Wesleyan-Soft-Robots-Lab/ArduinoMotors/Documentation/pneumaticuse.md

This is a tutorial on how to use the pneumatic board when testing using arm straps

THE ARDUINO BOARD
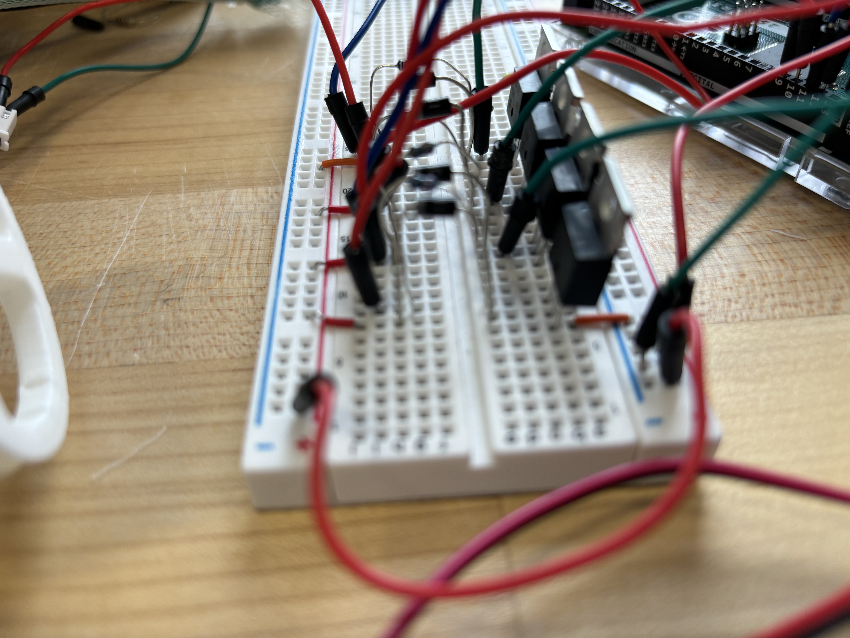
[picture p5: Documentation/images/circuit.jpeg]
1. 
To ensure that the solenoid works functionally, first we want to plug in the red and green wires connected to the solenoid into the board. 
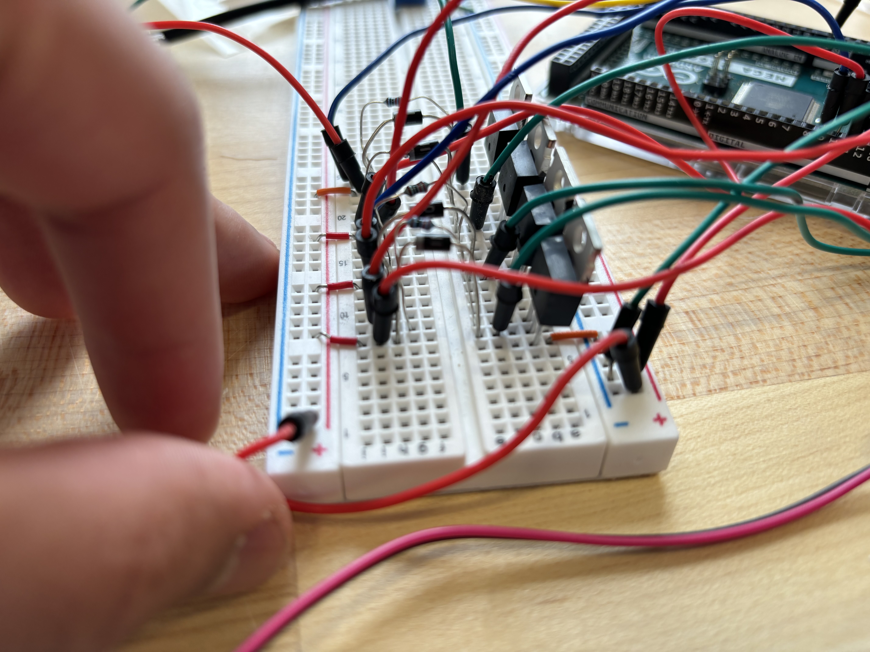
[picture p6: Documentation/images/circuitwire.jpeg]

The green wire should be plugged in to the right side of the board, in between the snubber diode and the transistor. The red wire should be plugged in to the left side of the board, right next to the left side of the snubber diode. 

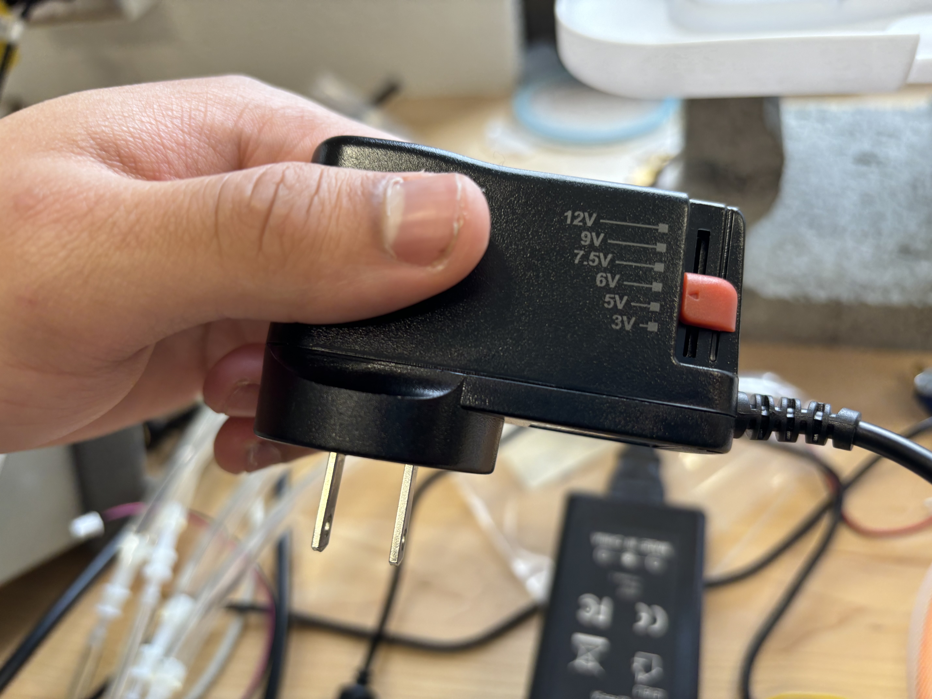
[picture p7: Documentation/images/powersupply.jpeg]
step 2
2. 
Ensure that the power supply is set to release 7.5V. 

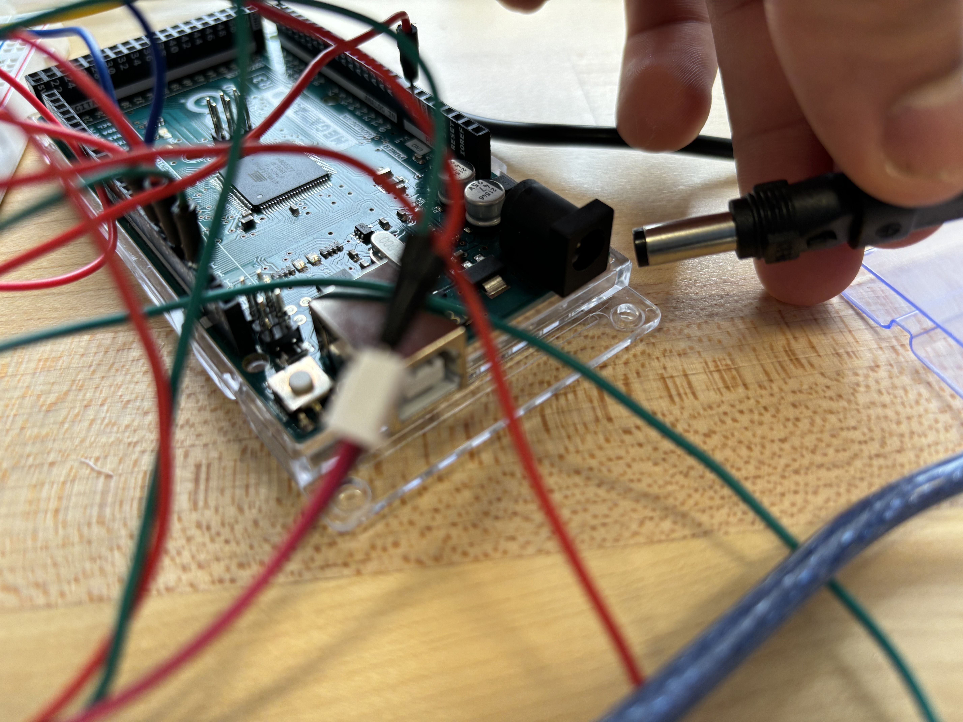
[picture p8: Documentation/images/power.jpeg]
step 3
3. 
Plug the power into the Arduino Mega.

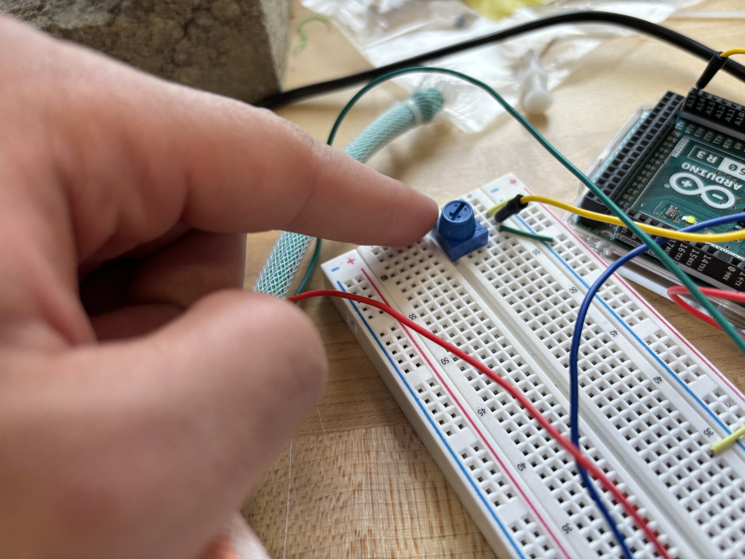
[picture p9: Documentation/images/valve.jpeg]
step 4
4. 

Once the Arduino is plugged in, turn the blue dial to increase or decrease the rate at which the air is being released to the balloon straps. This dial controls the rate at which the solenoid will open and close for airflow.

THE AIRPUMP

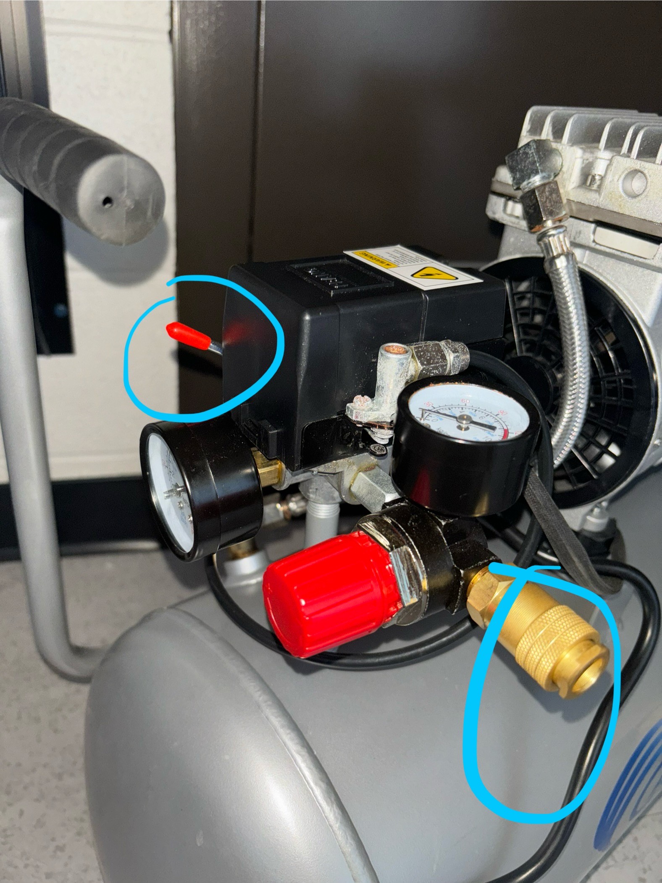
[picture p10: Documentation/images/pumpon.jpeg]
step 5
5. 

First, we want to ensure that the airpump is plugged into a power source. Once that is complete, there are two important parts to be aware of. The top circled part is to turn on the airpump. The bottom knozzle is to release the air into our board. To fill the pump with air, flip the top red switch on and let it fill. (I usually fill the pump up to 30kpa, for our current 4 tube model. However you may need more or less depending on your needs)

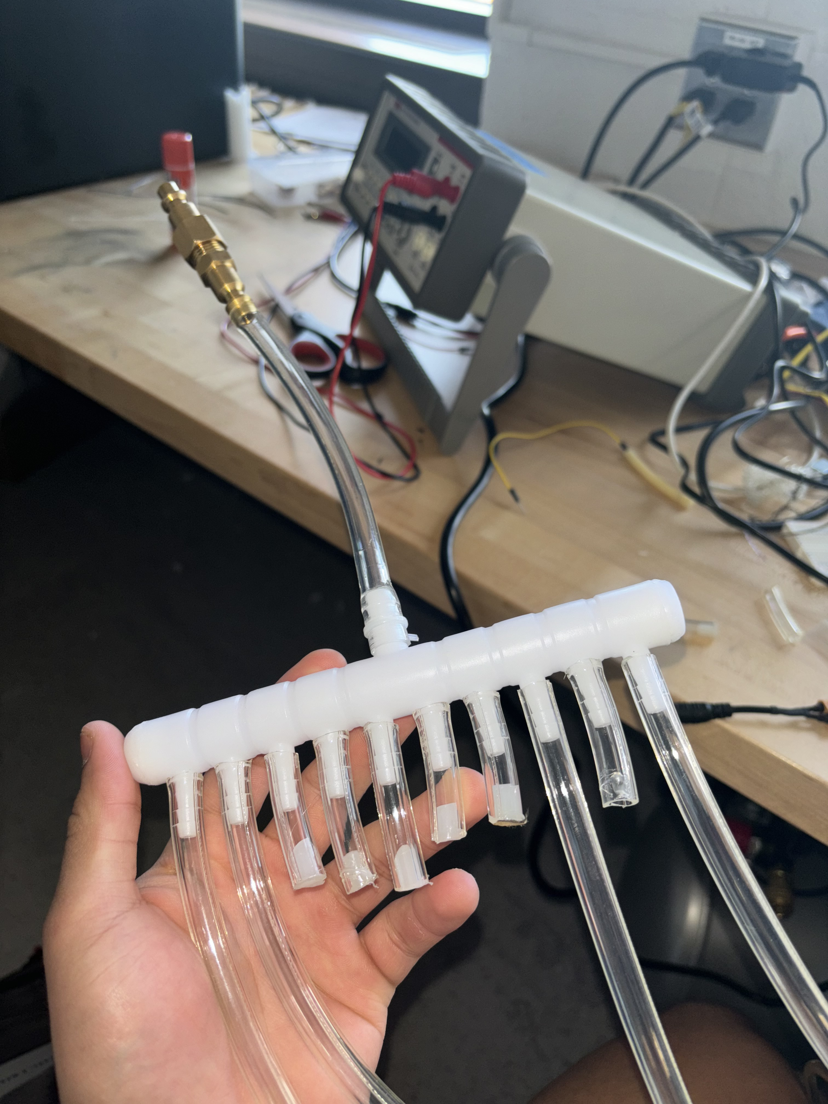
[picture p11: Documentation/images/tubeplug.jpeg]
6. 

Take the air tube divider. Ensure that every output which will not be used is plugged so that no air is lost. Then ensure that the ones that will be used are plugged in correctly.

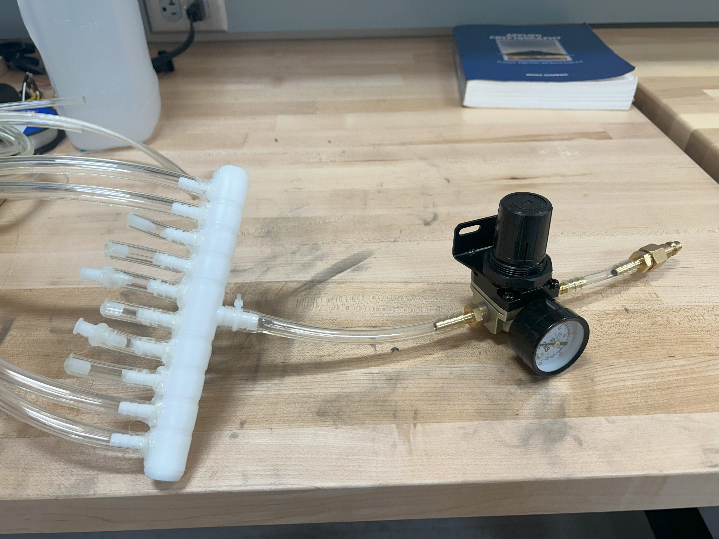
[picture p12: Documentation/images/regulator.jpeg]
6a.  

At the input of the airtube divider a pressure regulator has been installed to allow for finer adjustments to the pressure release. To increases airflow, rotate the valve clockwise. Rotating the valve counter-clockwise decreases airflow.
<br>***note: the valve has a push lock. The adjustment is locked when pushed in, and unlocked when out***

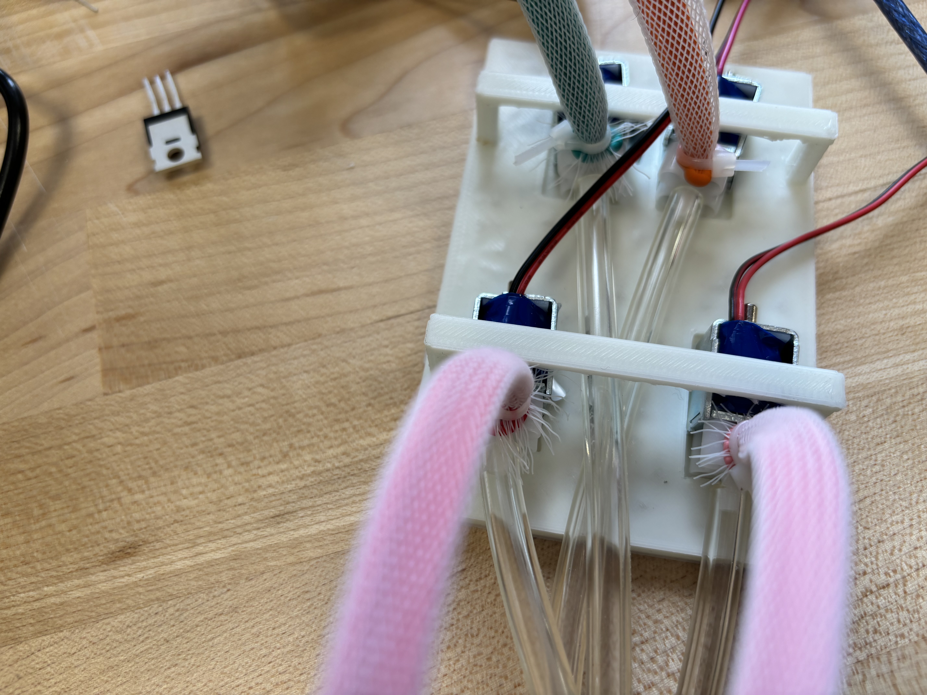
[picture p13: Documentation/images/tubing.jpeg]
step 7
7. 

Now ensure that the tubes are correctly connected to the pneumatic board as shown in the image above. 

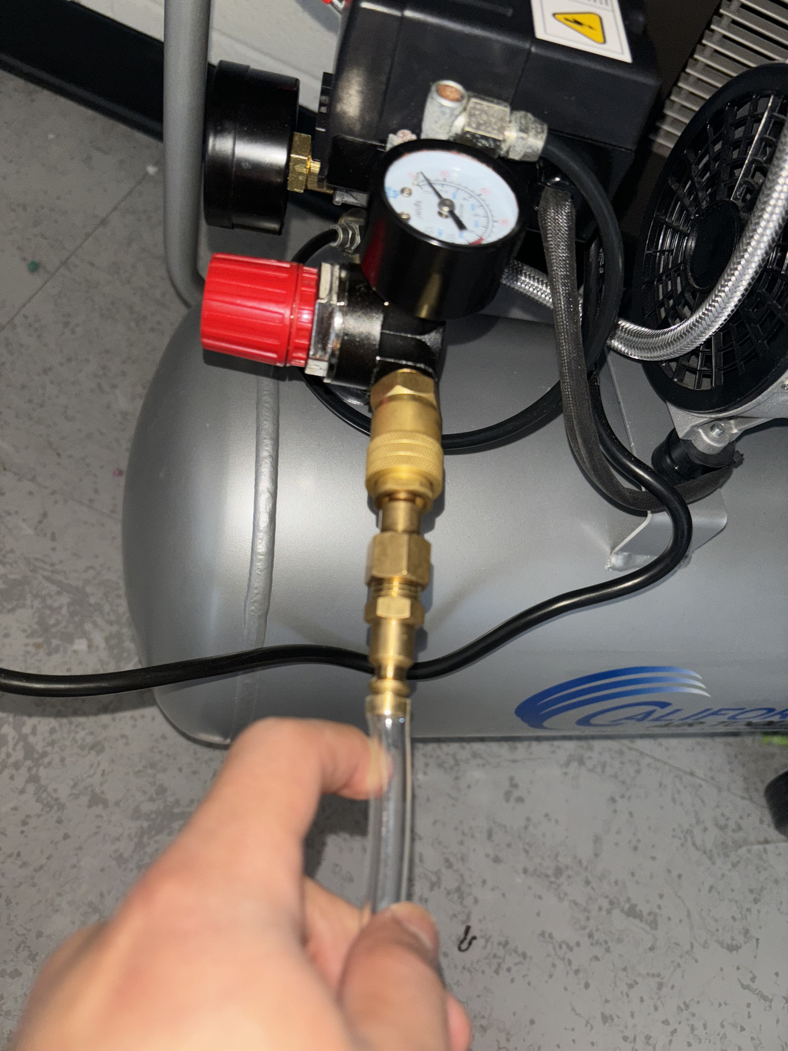
[picture p14: Documentation/images/tubeplugin.jpeg]
step 8
8. 

Plug our tube piece to the knozzle of the airpump. Once this is plugged in, air will immediately begin to flow out of the pump. Once air flows out, you can use the regulator to control the airflow into the balloons. Additionally, if you want more continuous airflow, you can turn on the airpump again to fill it while its releasing air.
<br> <b> Warning: The regulator acts as a bit of a buffer to ensuring steady outflow, though the airtank pressure will still build up at a faster rate than it is released.</b>

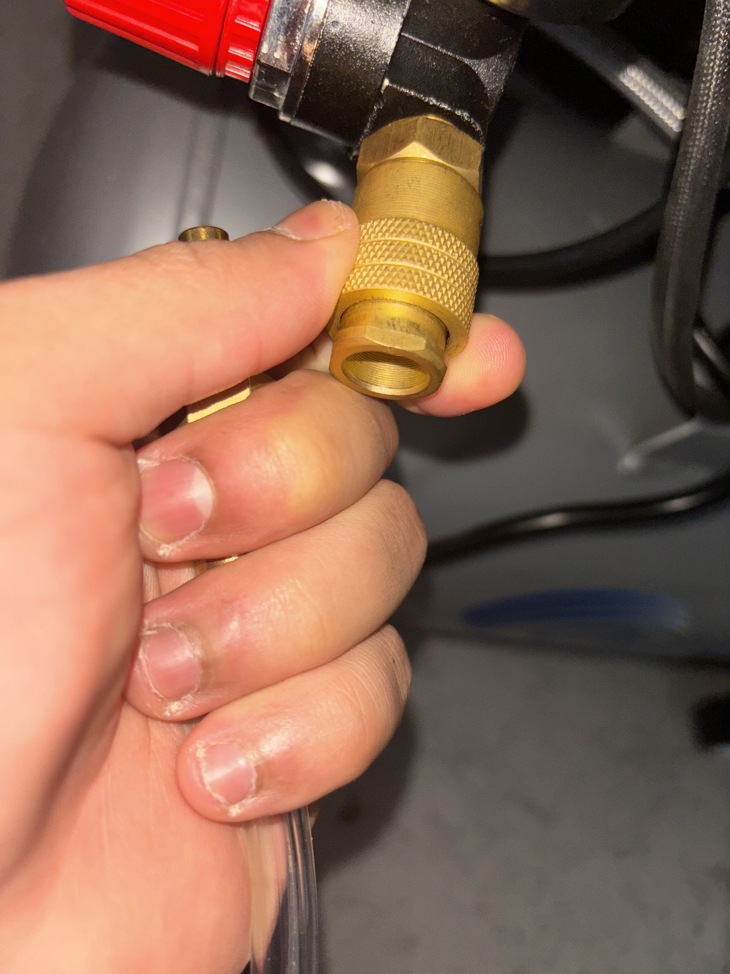
[picture p15: Documentation/images/unplug.jpeg]
step 9
9. 

Once finished, to unplug the tubing, pull on the knozzle as shown in the image. This will expel the tubing from the knozzle and stop the air flow. Additionally, if fully finished using the airpump, release the air from the bottom of the airpump using the small switch at the very bottom.

These are all the step to make the airpump/pneumatic board work. Update this document as we update our board.

Update Log:
- 11/4/2024 -- Miles Modeste
- 4/30/2024 -- Christian Diaz Herrera
