Wesleyan-Soft-Robots-Lab/ArduinoMotors/Documentation/Balloonsleevetut.md

## Instruction for making balloon sleeve

Materials for 1 balloon sleeve:
- 1 Balloon
- 1 Sleeve
- 1 Open plug (shorter)
- 1 Closed plug (longer)
- 2 zip ties 

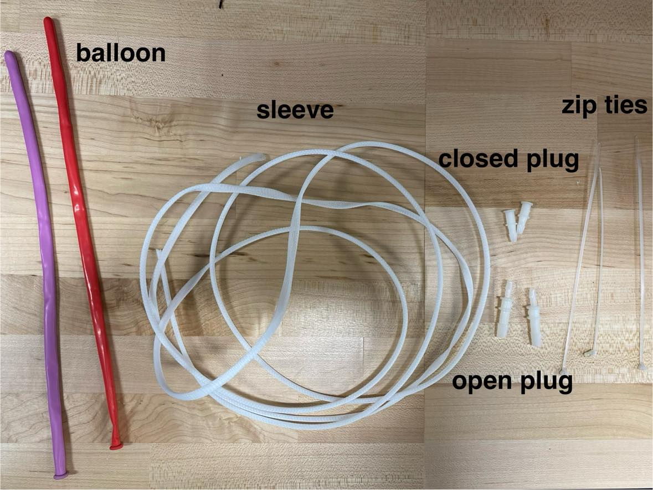
[picture p16: Documentation/images/balloon0.jpg]


1. Insert the open plug into the balloon’s lip 

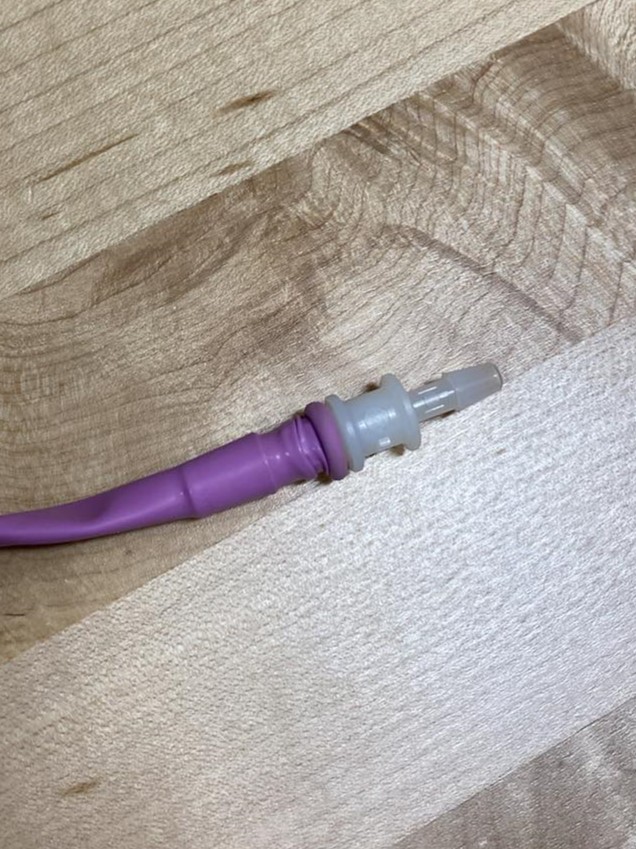
[picture p17: Documentation/images/balloon1.jpg]


2. Cut open the closed end of the balloon 

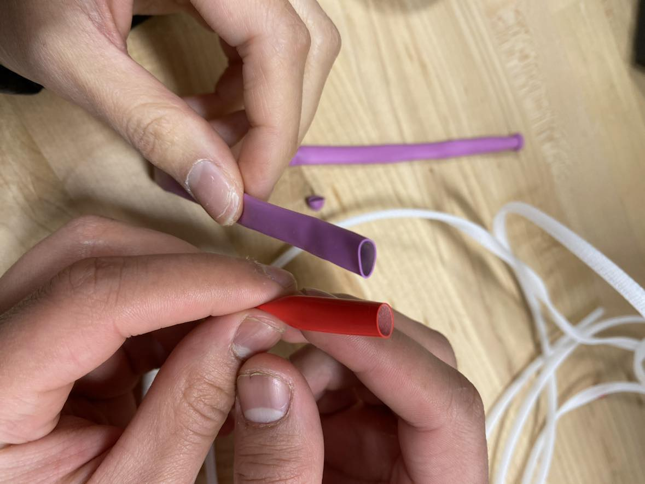
[picture p18: Documentation/images/balloon2.jpg]
step 2


3. Insert the closed plug all the way up 

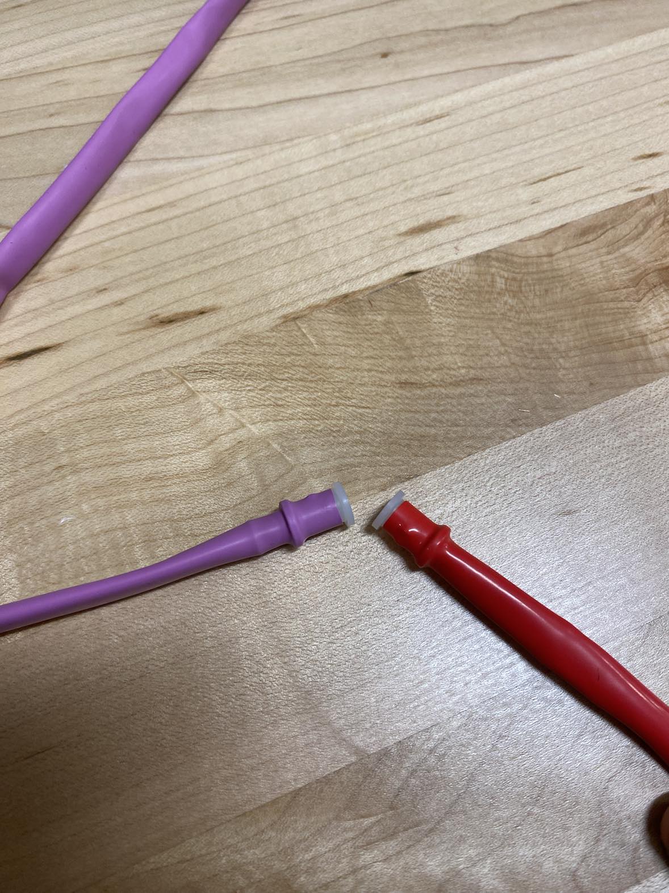
[picture p19: Documentation/images/balloon3.jpg]
step 3


4. Start inserting the closed plug end into the sleeve and push it through until the entire balloon is inside the sleeve

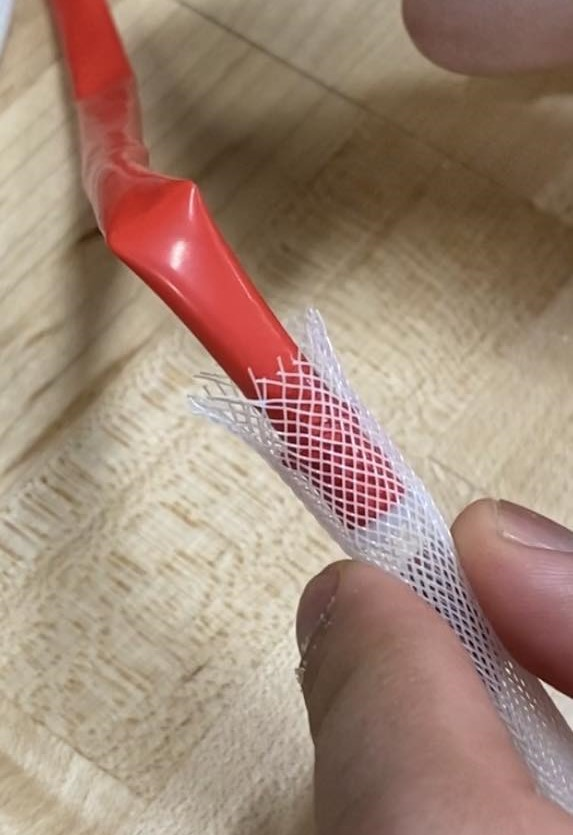
[picture p20: Documentation/images/balloon4.jpg]
step 4

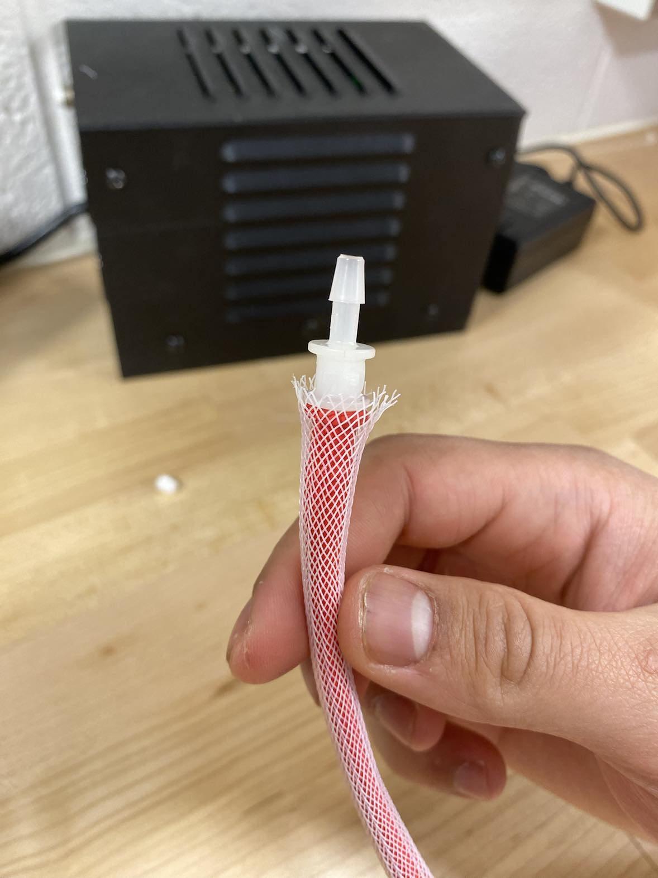
[picture p21: Documentation/images/balloon4.1.jpg]
step 4.1


5. Cut the sleeve (leave a little excess to zip tie later)

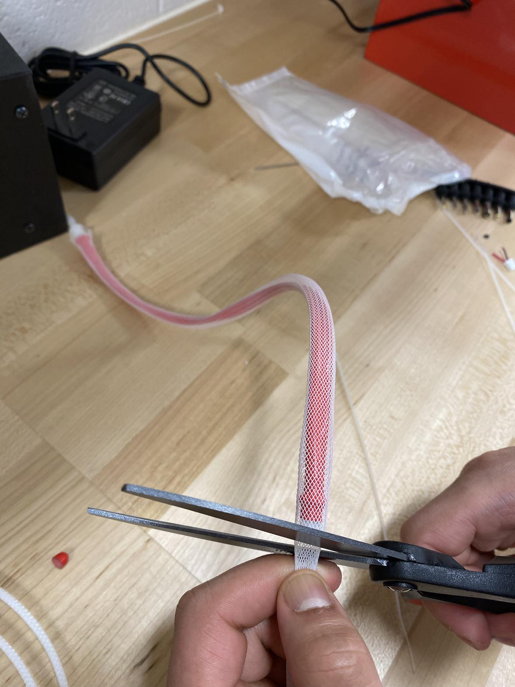
[picture p22: Documentation/images/balloon5.jpg]
step 5


6. Zip tie both ends as tight as possible and cut the excess zip tie

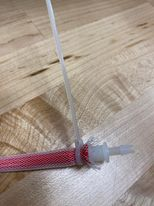
[picture p23: Documentation/images/balloon6.jpg]
step 6

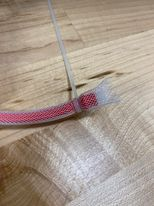
[picture p24: Documentation/images/balloon6.1.jpg]
step 6.1


7. The final product should look like this

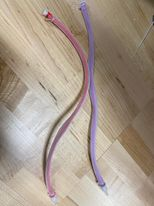
[picture p25: Documentation/images/balloon7.jpg]
step 7
