Wesleyan-Soft-Robots-Lab/ArduinoMotors/Model/model1/LSTMRegressor_5_acc.png

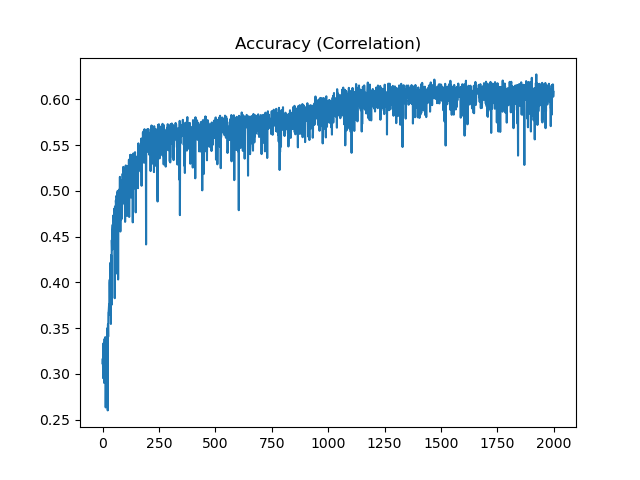
Model/model1/LSTMRegressor_5_acc.png
