Wesleyan-Soft-Robots-Lab/ArduinoMotors/Model/model1/LSTMRegressor_5_loss.png

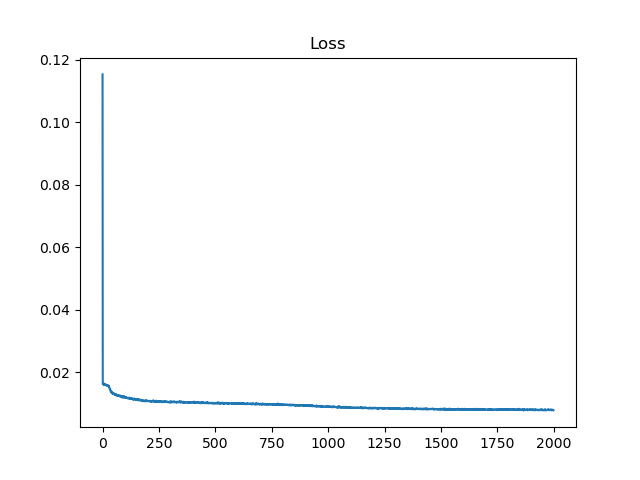
Model/model1/LSTMRegressor_5_loss.png
