Wesleyan-Soft-Robots-Lab/ArduinoMotors/Model/model1/LSTMRegressor_10_acc.png

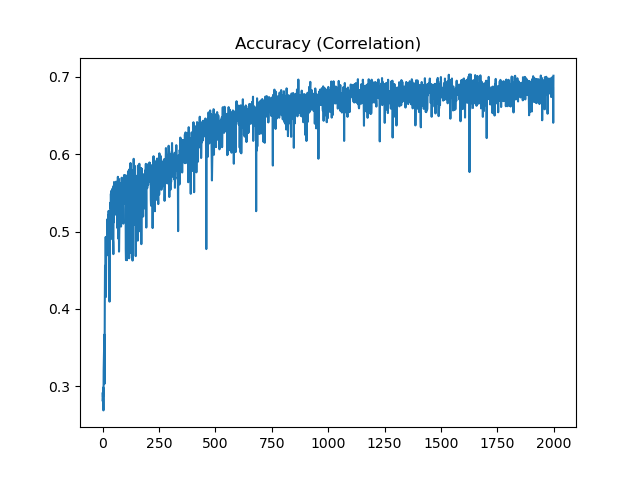
Model/model1/LSTMRegressor_10_acc.png
