Wesleyan-Soft-Robots-Lab/ArduinoMotors/Model/model1/LSTMRegressor_10_loss.png

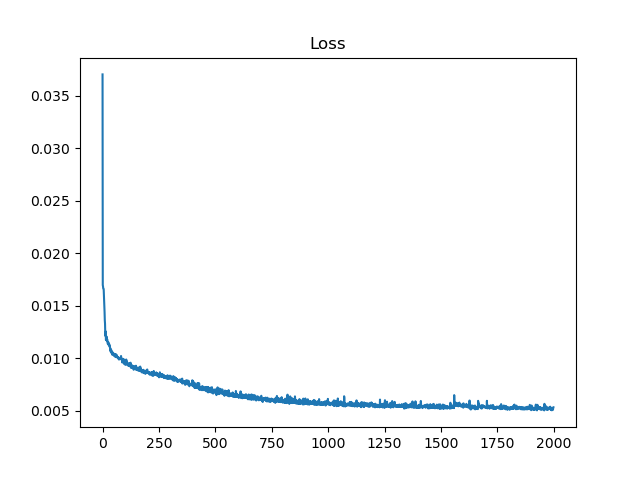
Model/model1/LSTMRegressor_10_loss.png
