Wesleyan-Soft-Robots-Lab/ArduinoMotors/Model/model1/LSTMRegressor_15_acc.png

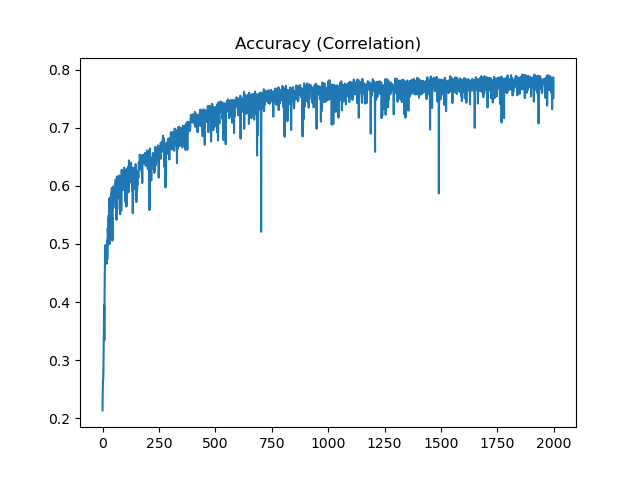
Model/model1/LSTMRegressor_15_acc.png
