Wesleyan-Soft-Robots-Lab/ArduinoMotors/Model/model1/LSTMRegressor_25_acc.png

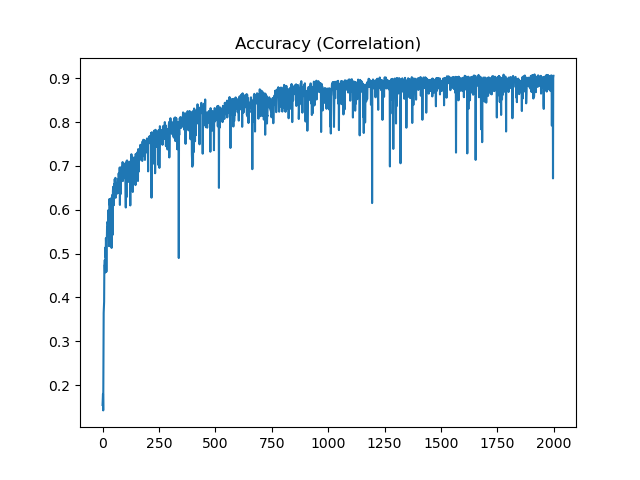
Model/model1/LSTMRegressor_25_acc.png
