Wesleyan-Soft-Robots-Lab/ArduinoMotors/Model/model1/LSTMRegressor_30_acc.png

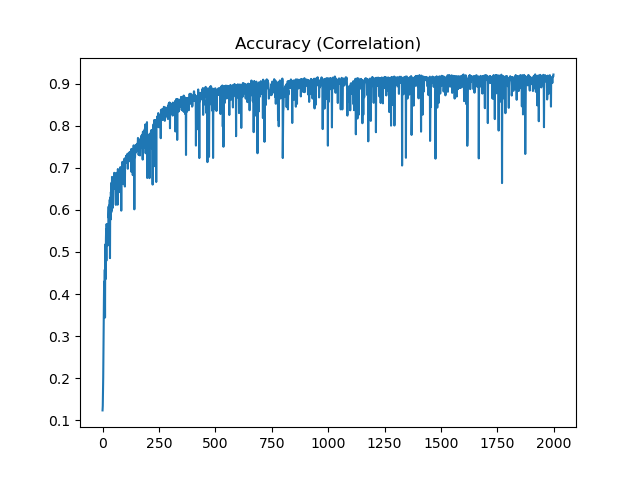
Model/model1/LSTMRegressor_30_acc.png
