Wesleyan-Soft-Robots-Lab/ArduinoMotors/Model/model1/LSTMRegressor_40_acc.png

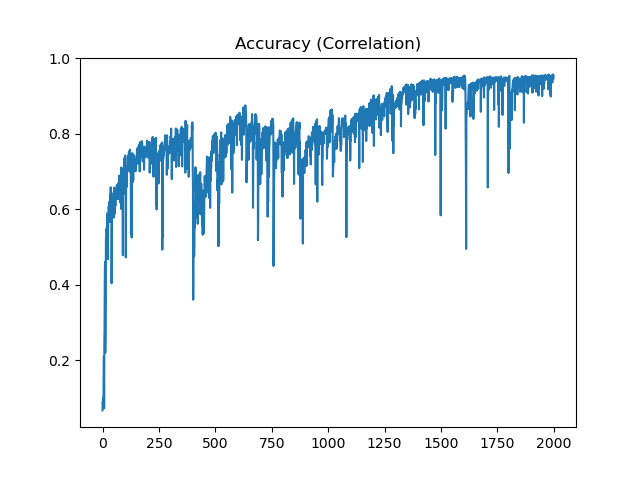
Model/model1/LSTMRegressor_40_acc.png
