Wesleyan-Soft-Robots-Lab/ArduinoMotors/Model/model1/LSTMRegressor_40_loss.png

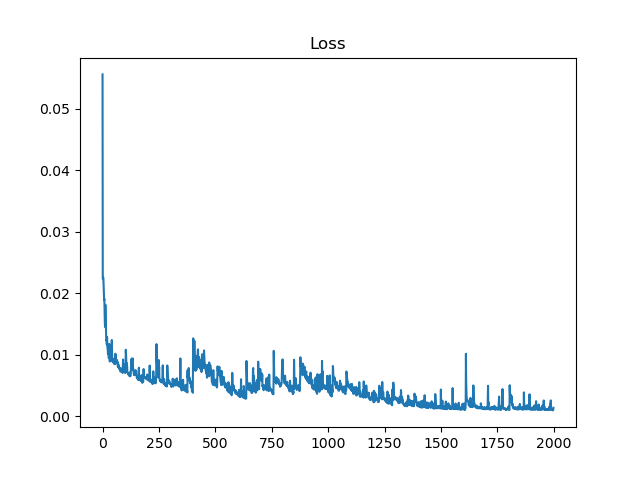
Model/model1/LSTMRegressor_40_loss.png
