Wesleyan-Soft-Robots-Lab/ArduinoMotors/Model/model1/LSTMRegressor_42_loss.png

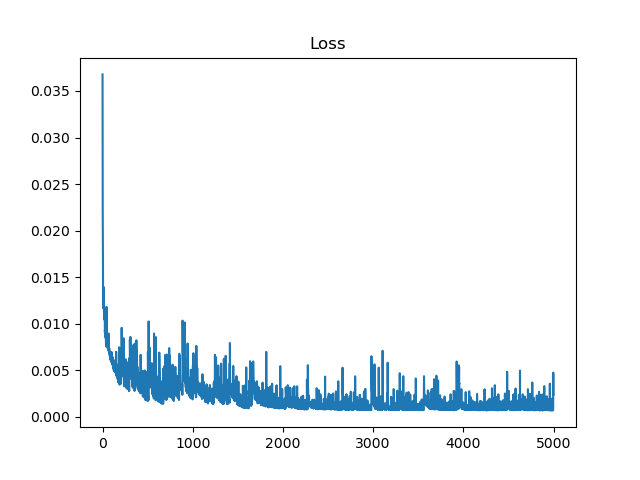
Model/model1/LSTMRegressor_42_loss.png
