Wesleyan-Soft-Robots-Lab/ArduinoMotors/Model/model1/serial_acc.png

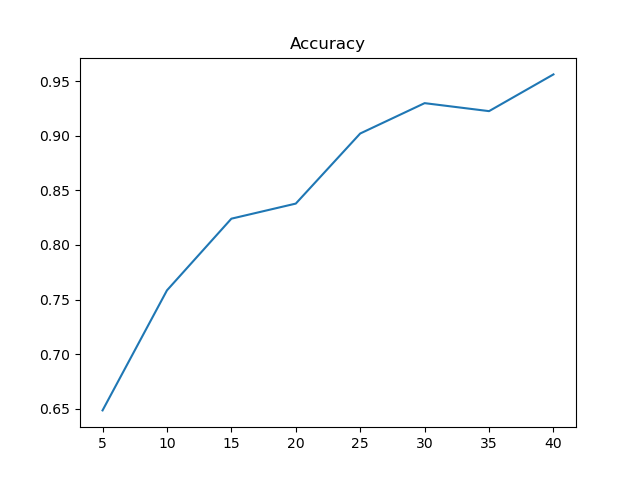
Model/model1/serial_acc.png
