Wesleyan-Soft-Robots-Lab/ArduinoMotors/Model/model/LSTMRegressor_strap_1_acc.png

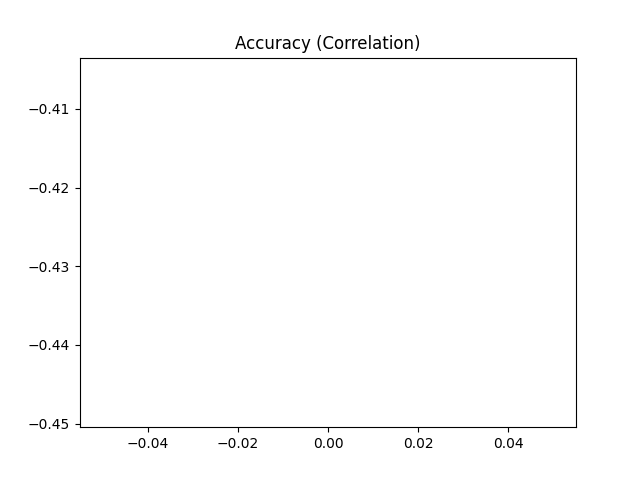
Model/model/LSTMRegressor_strap_1_acc.png
