Wesleyan-Soft-Robots-Lab/ArduinoMotors/Model/model/LSTMRegressor_strap_1_loss.png

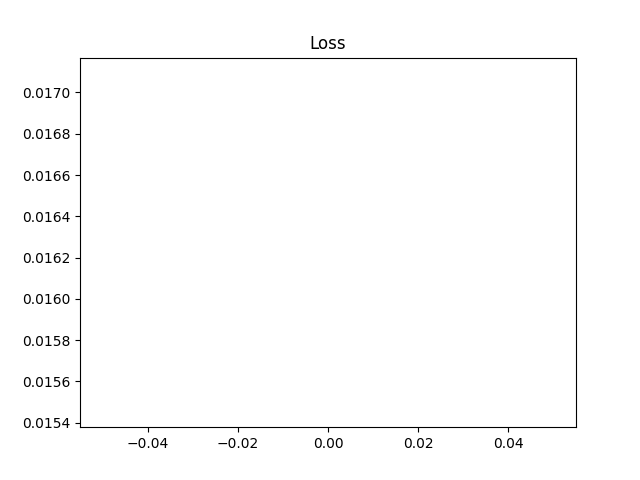
Model/model/LSTMRegressor_strap_1_loss.png
