Wesleyan-Soft-Robots-Lab/ArduinoMotors/Model/model/LSTMRegressor_strap_20_acc.png

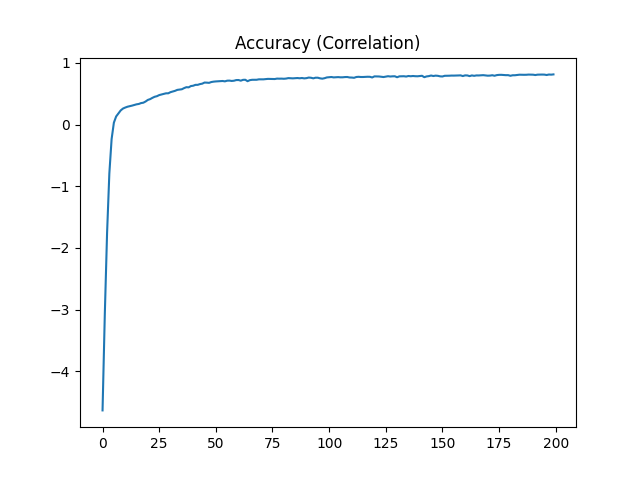
Model/model/LSTMRegressor_strap_20_acc.png
