Wesleyan-Soft-Robots-Lab/ArduinoMotors/Model/model/LSTMRegressor_strap_20_loss.png

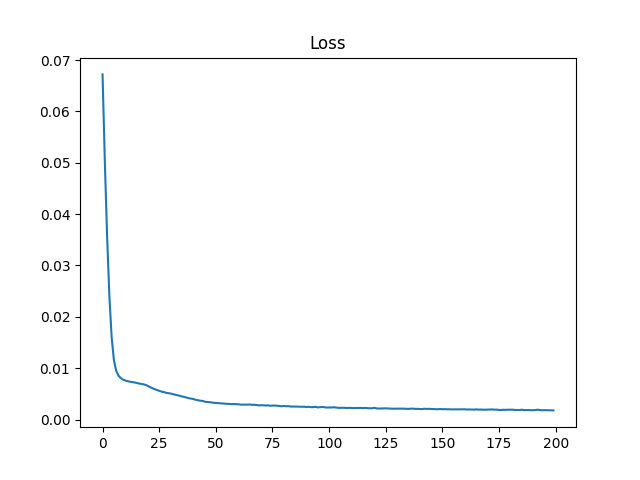
Model/model/LSTMRegressor_strap_20_loss.png
