Wesleyan-Soft-Robots-Lab/ArduinoMotors/Model/model/LSTMRegressor_strap_42_acc.png

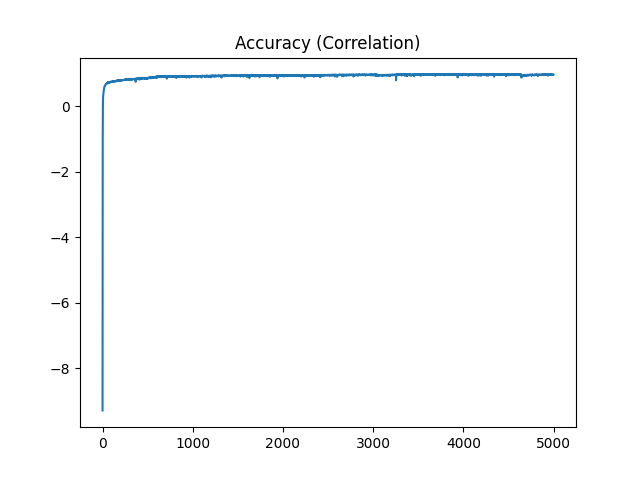
Model/model/LSTMRegressor_strap_42_acc.png
