Wesleyan-Soft-Robots-Lab/ArduinoMotors/Model/model/LSTMRegressor_strap_fullnum_30_acc.png

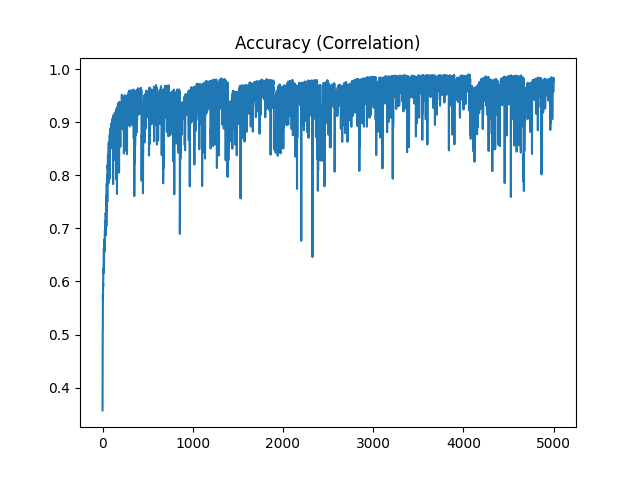
Model/model/LSTMRegressor_strap_fullnum_30_acc.png
