Wesleyan-Soft-Robots-Lab/ArduinoMotors/Model/model/LSTMRegressor_strap_norm_1_loss.png

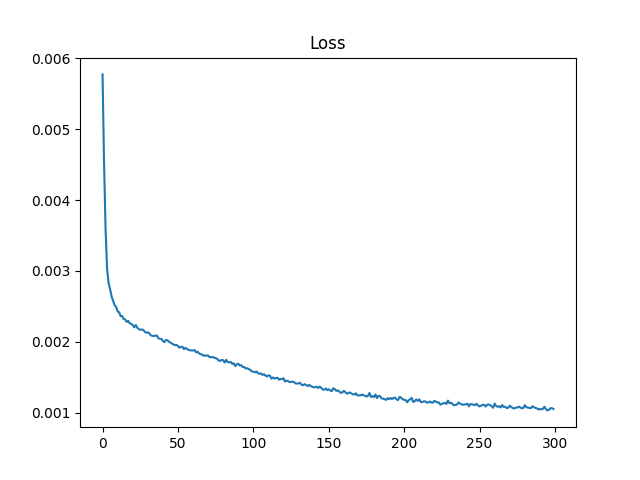
Model/model/LSTMRegressor_strap_norm_1_loss.png
