Wesleyan-Soft-Robots-Lab/ArduinoMotors/Model/model/LSTMRegressor_strap_norm_3_loss.png

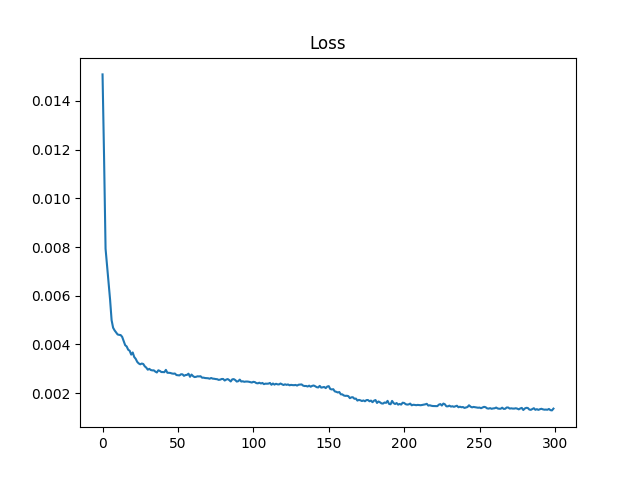
Model/model/LSTMRegressor_strap_norm_3_loss.png
