Wesleyan-Soft-Robots-Lab/ArduinoMotors/Model/model/LSTMRegressor_strap_norm_5_loss.png

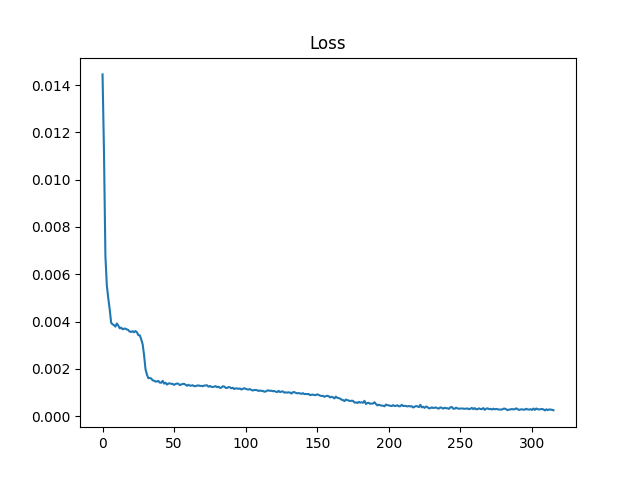
Model/model/LSTMRegressor_strap_norm_5_loss.png
