Wesleyan-Soft-Robots-Lab/ArduinoMotors/Model/model/LSTMRegressor_strap_norm_7_loss.png

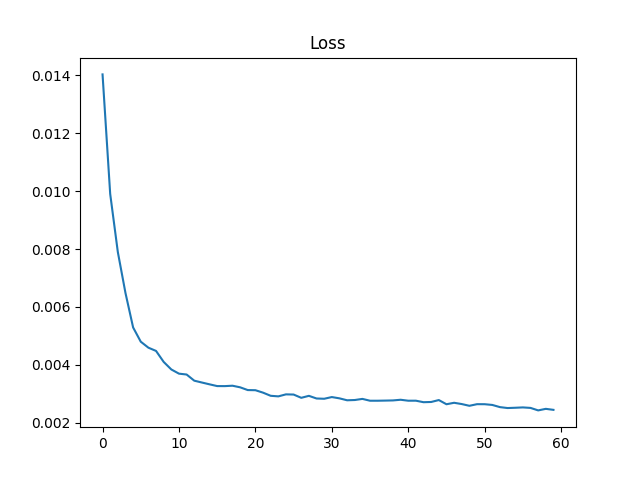
Model/model/LSTMRegressor_strap_norm_7_loss.png
