Wesleyan-Soft-Robots-Lab/ArduinoMotors/3DMODELING/0_Solenoid6V_Tray_4x_2-19.stl

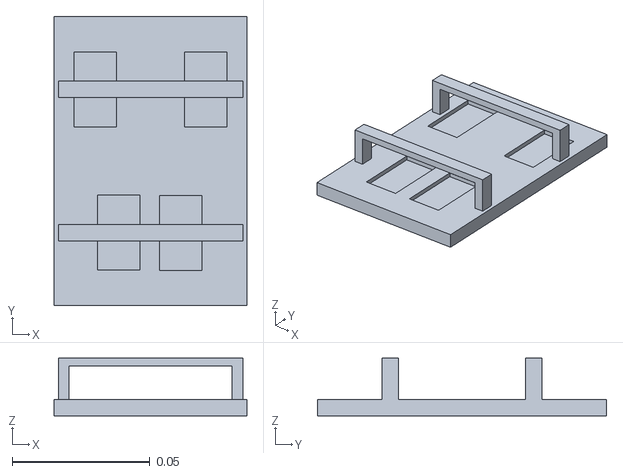
[picture p56: CAD file, 2024-04-30]
3DMODELING/0_Solenoid6V_Tray_4x_2-19.stl
0.07 x 0.105 x 0.0209
