Wesleyan-Soft-Robots-Lab/ArduinoMotors/3DMODELING/Solenoid6V_Tray_2_15.stl

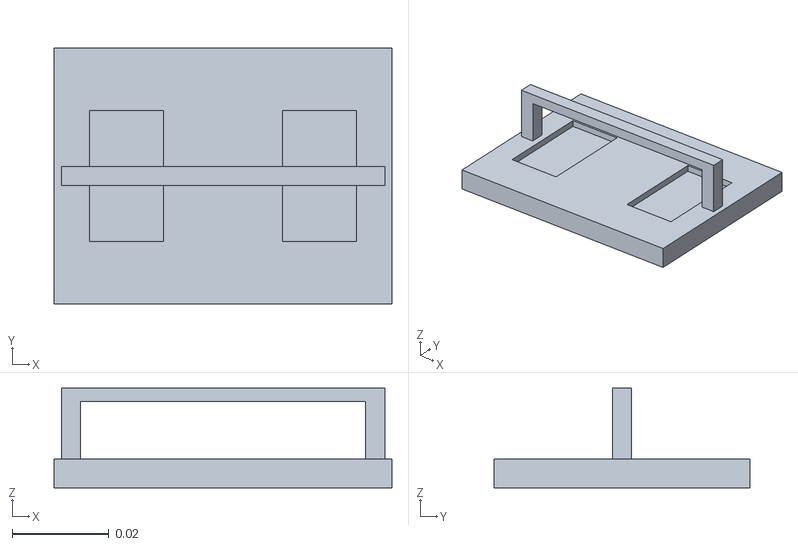
[picture p57: CAD file, 2024-02-27]
3DMODELING/Solenoid6V_Tray_2_15.stl
0.07 x 0.053 x 0.0207
