Wesleyan-Soft-Robots-Lab/ArduinoMotors/3DMODELING/solenoid.3mf

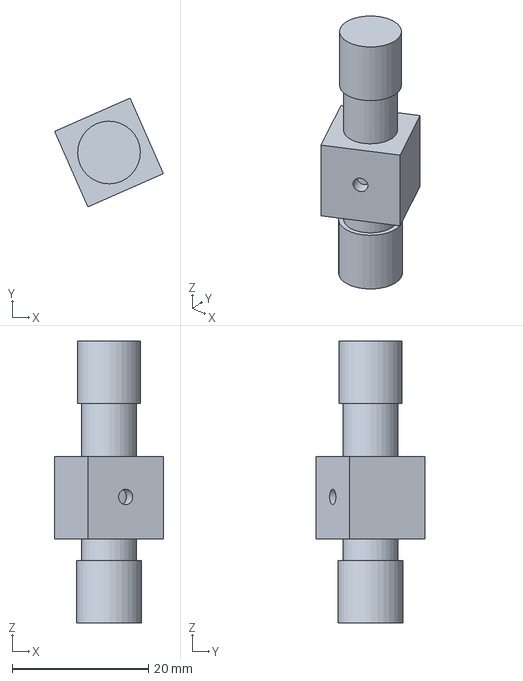
[picture p58: CAD file, 2024-02-27]
3DMODELING/solenoid.3mf
16.0 x 16.0 x 41.5 mm
