Wesleyan-Soft-Robots-Lab/ArduinoMotors/3DMODELING/solval9.stl

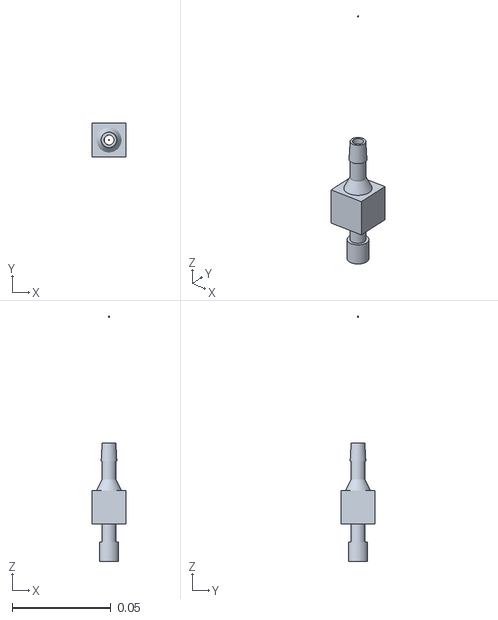
[picture p59: CAD file, 2024-02-27]
3DMODELING/solval9.stl
0.017 x 0.017 x 0.124
