Wesleyan-Soft-Robots-Lab/ArduinoMotors/3DMODELING/solval3.3mf

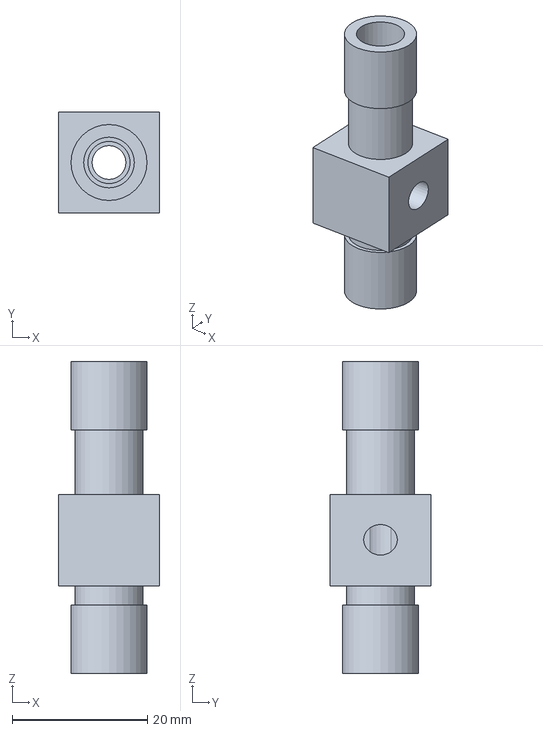
[picture p60: CAD file, 2024-02-27]
3DMODELING/solval3.3mf
15.0 x 15.0 x 46.2 mm
