Wesleyan-Soft-Robots-Lab/ArduinoMotors/3DMODELING/solval4.3mf

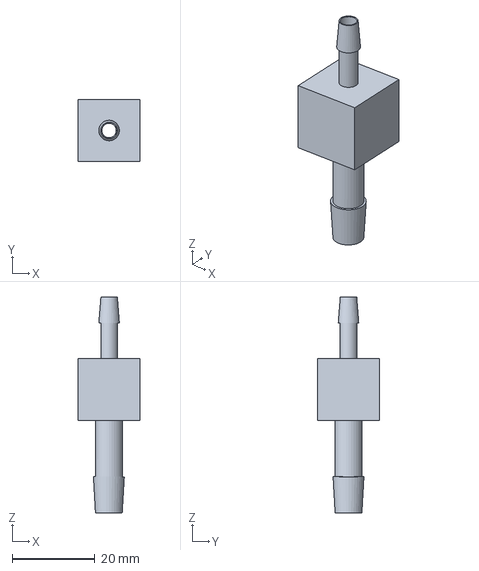
[picture p61: CAD file, 2024-02-27]
3DMODELING/solval4.3mf
15.0 x 15.0 x 52.3 mm
