Wesleyan-Soft-Robots-Lab/ArduinoMotors/3DMODELING/imsad.stl

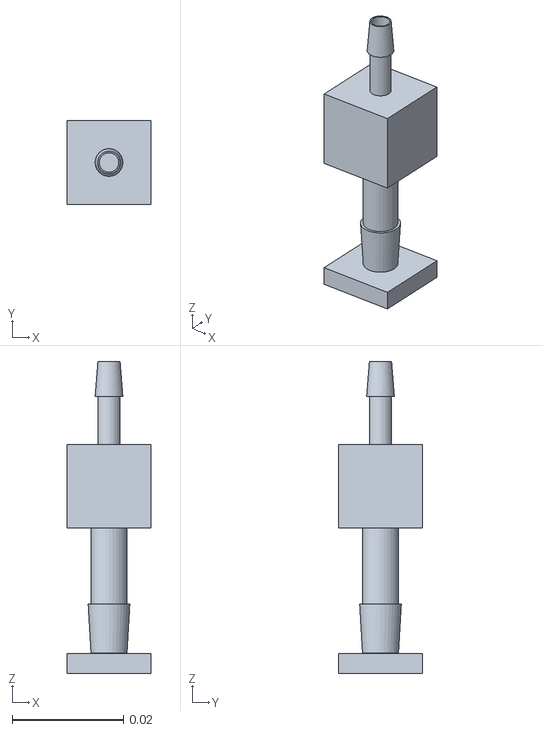
[picture p62: CAD file, 2024-02-27]
3DMODELING/imsad.stl
0.015 x 0.015 x 0.056
