Wesleyan-Soft-Robots-Lab/ArduinoMotors/3DMODELING/solenoidvalve2.3mf

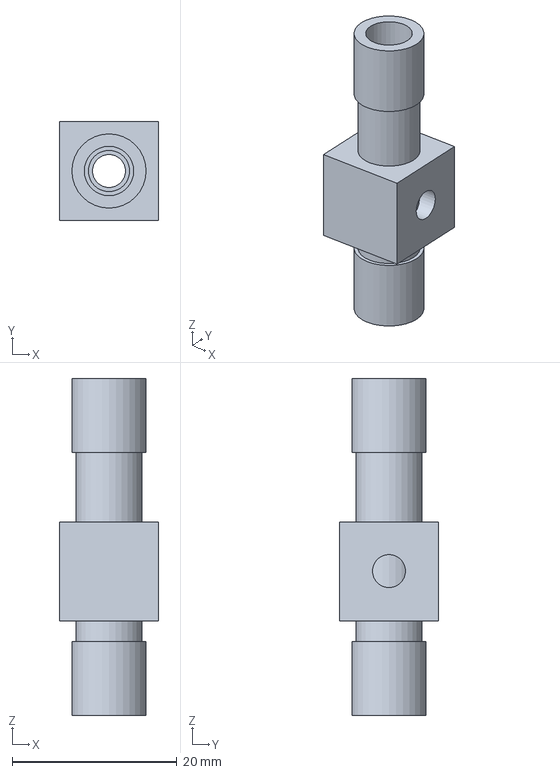
[picture p63: CAD file, 2024-02-27]
3DMODELING/solenoidvalve2.3mf
12.0 x 12.0 x 40.9 mm
