Wesleyan-Soft-Robots-Lab/ArduinoMotors/3DMODELING/solval8.3mf

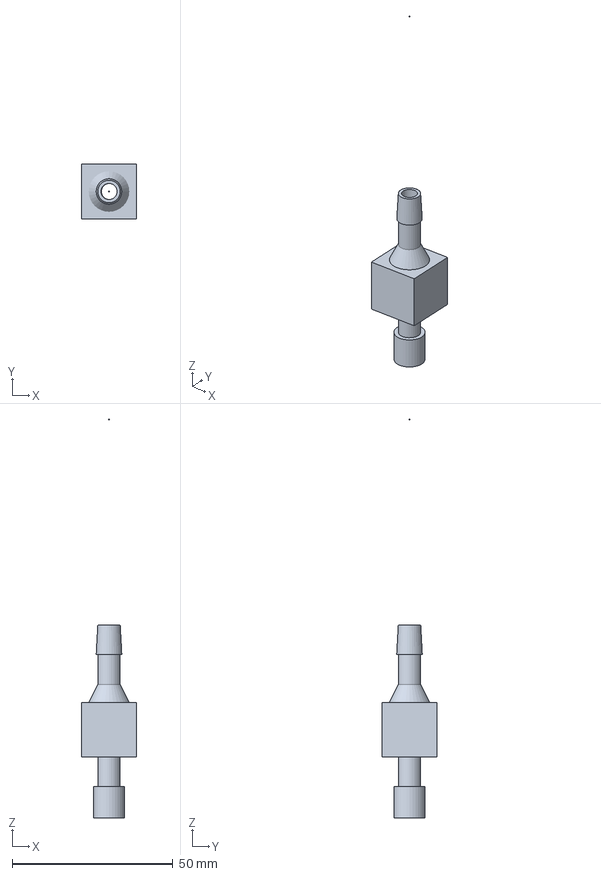
[picture p64: CAD file, 2024-02-27]
3DMODELING/solval8.3mf
17.0 x 17.0 x 124.2 mm
