Wesleyan-Soft-Robots-Lab/ArduinoMotors/(list of files, cad)

Other CAD files:
3DMODELING/solval7.3mf
3DMODELING/solenoid.blend
3DMODELING/solenoid.stl
3DMODELING/solenoidvalve2.stl
3DMODELING/solval3.stl
3DMODELING/solval4.stl
3DMODELING/solval7.stl
3DMODELING/solval8.stl
