Wesleyan-Soft-Robots-Lab/ArduinoMotors/Documentation/Pneumaticbuild.md

<h1>Connecting and Controlling Air Valves with Arduino: A Step-by-Step Guide.</h1>

<h2> Components: </h2> 
<br/>



MOSFET Transistor (IRF520PBF) rated for 9.2A

<br/>


Breadboard

<br/>


Schottkey Diode (rated for at least 6V and 1 Amp) 1N4001 Diode

<br/>


(220 Ohms) Resistor

<br/>


6V Air 3-Way Soleniod Valve 

<br/>


Jumper wires
<br/>


Balloons

<br/>


Plastic cap (for ballons)

<br/>


Expandable sleeving

<br/>


Potentiometer -- 0-10k Ohms

<br/>


Everything!

<h2> How to put together: </h2>

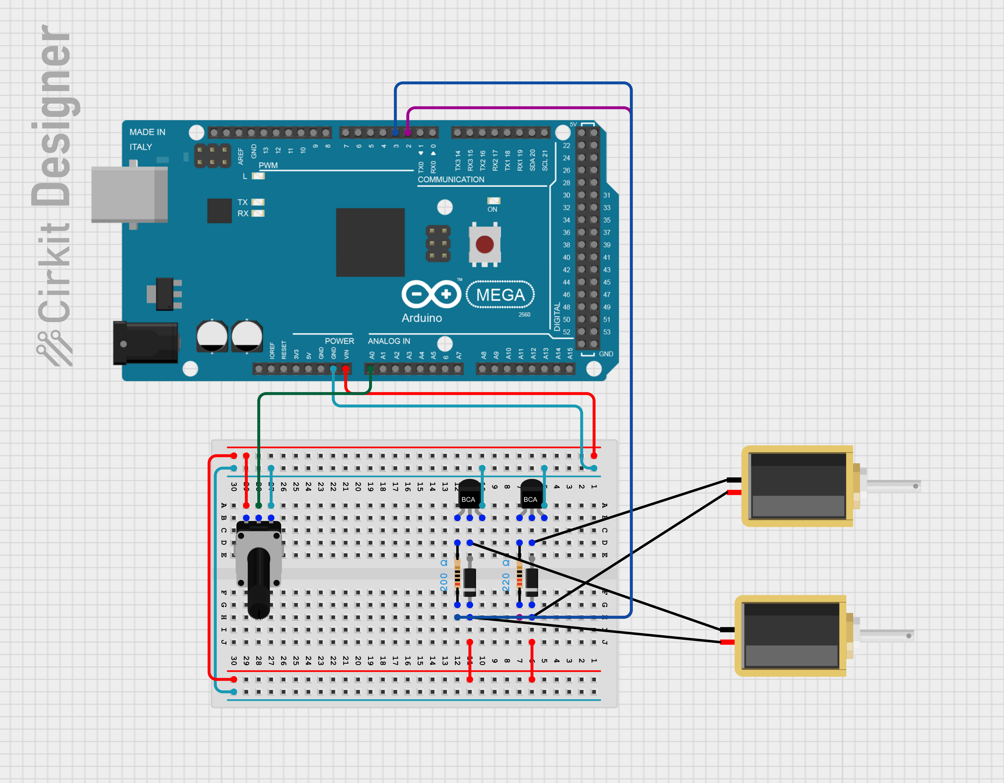
[picture p65: Documentation/images/circuit_image.png]


1. **Arduino Power Supply**:
  - The Arduino receives power through the USB port, providing 5V and ground (GND) to the board. However, since we will be using 6.5V air valves, an external power supply is necessary. This can be connected either through the Arduino's port or directly to the breadboard.

2. **Potentiometer Connections**:
   - **Left Pin (VCC)**: The left pin of the potentiometer is connected to the 5V/Vin power rail on the breadboard. This supplies the potentiometer with a constant 5V.
   - **Middle Pin (Output)**: The middle pin of the potentiometer (the wiper) is connected to the analog pin A0 on the Arduino via a purple wire. This pin outputs a variable voltage (depending on the position of the potentiometer knob) between 0V and 5V.
   - **Right Pin (GND)**: The right pin of the potentiometer is connected to the ground (GND) rail on the breadboard. This completes the circuit for the potentiometer, allowing it to divide the 5V across its range.

3. **Breadboard Power Rails**:
   - **Red Rail**: The red power rail on the breadboard is connected to the 5V/Vin pin on the Arduino via a red wire. This rail provides 5V to components on the breadboard.
   - **Blue Rail**: The blue ground rail on the breadboard is connected to a GND pin on the Arduino via a blue wire. This rail provides a common ground to the components on the breadboard.

4. **NMOS Transistor Connections**:
   - **Gate (G)**: The gate pin of the NMOS transistor is connected to digital pin 13 on the Arduino via an orange wire. This pin controls the transistor's switching, turning it on and off.
   - **Drain (D)**: The drain pin of the NMOS transistor is connected to one terminal of the motor (Air Valve). When the transistor is turned on, current flows from the drain to the source, allowing the motor (Air Valve) to operate.
   - **Source (S)**: The source pin of the NMOS transistor is connected to the ground rail on the breadboard. This provides a path for current to flow through the transistor when it is turned on.

5. **Motor Connections**:
   - **Negative Terminal**: The negative terminal of the motor is connected to the drain (D) of the NMOS transistor. This allows the motor to be controlled by the transistor.
   - **Positive Terminal**: The positive terminal of the motor is connected to the 5V power rail on the breadboard. This supplies the motor with power.

6. **Diode**:
   - The diode is connected across the motor terminals. The cathode (marked end) is connected to the positive terminal of the motor, and the anode is connected to the drain (D) of the NMOS transistor. This diode protects the circuit from voltage spikes caused by the inductive load of the motor.

7. **Current-Limiting Resistor**:
   - A resistor is connected between the gate (G) of the NMOS transistor and digital pin 13 on the Arduino. This resistor limits the current flowing into the gate of the transistor, protecting the Arduino pin.

### How It Works
- When you rotate the potentiometer, it changes the voltage at its middle pin, which is read by the Arduino on analog pin A0.
- The Arduino processes this analog reading to set the output signal on digital pin 13. If the signal is high, the air valve opens and closes rapidly; if the signal is low, the opposite happens (refer to the code to understand the detailed logic).

Update Log: 

11/29/2024 by Christian Diaz Herrera

5/16/2024 by Kevin Angulo Lezama
