Wesleyan-Soft-Robots-Lab/ArduinoMotors/TestData/take1/angles_output.csv

imgnum | timestamp | Angle1(deg) | Angle2(deg)
0 | 1734294927.7241762 | 16.011828371399204 | 2.8864185438646075
1 | 1734294927.770111 | 16.011828371399204 | 2.8864185438646075
2 | 1734294927.8211694 | 16.011828371399204 | 2.8864185438646075
3 | 1734294927.872889 | 16.011828371399204 | 2.8864185438646075
4 | 1734294927.9257357 | 16.011828371399204 | 2.8864185438646075
5 | 1734294927.9788358 | 16.011828371399204 | 2.8864185438646075
6 | 1734294928.0346138 | 16.011828371399204 | 2.8864185438646075
7 | 1734294928.0892515 | 16.011828371399204 | 2.8864185438646075
8 | 1734294928.1416967 | 16.011828371399204 | 2.8864185438646075
9 | 1734294928.1952689 | 16.011828371399204 | 2.8864185438646075
10 | 1734294928.2462387 | 16.011828371399204 | 2.8864185438646075
11 | 1734294928.293002 | 16.011828371399204 | 2.8864185438646075
12 | 1734294928.3471355 | 15.548530279057402 | 2.8864185438646075
13 | 1734294928.4012246 | 16.011828371399204 | 2.8864185438646075
14 | 1734294928.44922 | 16.011828371399204 | 2.8864185438646075
15 | 1734294928.499186 | 16.011828371399204 | 2.8864185438646075
16 | 1734294928.5503516 | 16.011828371399204 | 2.8864185438646075
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
