Wesleyan-Soft-Robots-Lab/ArduinoMotors/TestData/take1/sensor_data.csv

Time(s) | R1(O) | R2(O) | R3(O) | R4(O)
1734294927.7450628 | 96.43 | 92.37 | 99.11 | 99.53
1734294927.7774057 | 96.40 | 92.34 | 99.11 | 99.53
1734294927.8250372 | 96.40 | 92.34 | 99.11 | 99.53
1734294927.872889 | 96.40 | 92.32 | 99.11 | 99.53
1734294927.9257357 | 96.40 | 92.32 | 99.11 | 99.53
1734294927.9788358 | 96.40 | 92.32 | 99.11 | 99.51
1734294928.0346138 | 96.40 | 92.30 | 99.11 | 99.51
1734294928.0942788 | 96.38 | 92.30 | 99.11 | 99.51
1734294928.158494 | 96.38 | 92.30 | 99.11 | 99.51
1734294928.2024095 | 96.38 | 92.30 | 99.11 | 99.51
1734294928.2462387 | 96.38 | 92.30 | 99.11 | 99.51
1734294928.2945313 | 96.38 | 92.30 | 99.11 | 99.51
1734294928.3491688 | 96.38 | 92.30 | 99.11 | 99.51
1734294928.4074697 | 96.35 | 92.30 | 99.11 | 99.51
1734294928.44922 | 96.35 | 92.30 | 99.11 | 99.48
1734294928.501648 | 96.35 | 92.30 | 99.11 | 99.48
1734294928.5573492 | 96.35 | 92.32 | 99.11 | 99.48
1734294928.596644 | 96.35 | 92.32 | 99.11 | 99.48
1734294928.6675427 | 96.35 | 92.34 | 99.11 | 99.48
1734294928.7159843 | 96.33 | 92.34 | 99.11 | 99.48
1734294928.759045 | 96.33 | 92.34 | 99.11 | 99.48
1734294928.8166692 | 96.33 | 92.37 | 99.11 | 99.48
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
