Wesleyan-Soft-Robots-Lab/ArduinoMotors/TestData/take10/angles_output.csv

imgnum | timestamp | Angle1(deg) | Angle2(deg)
0 | 1734296232.4202197 | -5.383425932430825 | 4.436474485657357
1 | 1734296232.4476776 | -5.383425932430825 | 4.436474485657357
2 | 1734296232.4983754 | -5.391315739529546 | 4.436474485657357
3 | 1734296232.5462651 | -5.391315739529546 | 4.436474485657357
4 | 1734296232.5976367 | -5.391315739529546 | 4.436474485657357
5 | 1734296232.6485224 | -5.383425932430825 | 4.436474485657357
6 | 1734296232.697383 | -5.856740032056408 | 4.436474485657357
7 | 1734296232.7524097 | -5.856740032056408 | 4.436474485657357
8 | 1734296232.8071957 | -4.900027482909749 | 3.94518622903756
9 | 1734296232.859034 | -4.900027482909749 | 3.94518622903756
10 | 1734296232.9136484 | -4.900027482909749 | 3.94518622903756
11 | 1734296232.963222 | -4.892137675811028 | 3.94518622903756
12 | 1734296233.0162053 | -4.900027482909749 | 3.94518622903756
13 | 1734296233.0698168 | -4.900027482909749 | 3.94518622903756
14 | 1734296233.1289933 | -4.900027482909749 | 3.94518622903756
15 | 1734296233.181244 | -4.900027482909749 | 3.94518622903756
16 | 1734296233.2307577 | -4.900027482909749 | 3.94518622903756
17 | 1734296233.2817662 | -4.900027482909749 | 3.94518622903756
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
