Wesleyan-Soft-Robots-Lab/ArduinoMotors/TestData/take10/sensor_data.csv

Time(s) | R1(O) | R2(O) | R3(O) | R4(O)
1734296232.4252505 | 96.05 | 90.58 | 101.07 | 99.17
1734296232.4476776 | 96.05 | 90.58 | 101.05 | 99.17
1734296232.5056903 | 96.05 | 90.58 | 101.02 | 99.17
1734296232.5462651 | 96.05 | 90.58 | 100.99 | 99.20
1734296232.604993 | 96.05 | 90.58 | 100.97 | 99.20
1734296232.654533 | 96.05 | 90.58 | 100.94 | 99.20
1734296232.697383 | 96.05 | 90.58 | 100.91 | 99.20
1734296232.7697365 | 96.05 | 90.58 | 100.89 | 99.20
1734296232.812323 | 96.05 | 90.58 | 100.86 | 99.20
1734296232.8650181 | 96.05 | 90.58 | 100.84 | 99.20
1734296232.928018 | 96.05 | 90.58 | 100.81 | 99.20
1734296232.963222 | 96.05 | 90.58 | 100.78 | 99.20
1734296233.0238605 | 96.05 | 90.58 | 100.76 | 99.20
1734296233.0783179 | 96.05 | 90.58 | 100.76 | 99.20
1734296233.1289933 | 96.08 | 90.58 | 100.73 | 99.17
1734296233.18329 | 96.10 | 90.58 | 100.73 | 99.20
1734296233.2307577 | 96.15 | 90.58 | 100.76 | 99.25
1734296233.2817662 | 96.23 | 90.58 | 100.78 | 99.32
1734296233.3318188 | 96.33 | 90.58 | 100.81 | 99.38
1734296233.3874989 | 96.43 | 90.58 | 100.86 | 99.45
1734296233.4417927 | 96.53 | 90.58 | 100.91 | 99.53
1734296233.4966028 | 96.58 | 90.58 | 100.97 | 99.61
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
