Wesleyan-Soft-Robots-Lab/ArduinoMotors/TestData/take11/angles_output.csv

imgnum | timestamp | Angle1(deg) | Angle2(deg)
0 | 1734296337.8619294 | -3.9212515776859505 | 4.398705354995528
1 | 1734296337.9008882 | -4.885202568117293 | 4.885202568117293
2 | 1734296337.9521546 | -3.962966426922435 | 4.436474485657357
3 | 1734296337.9996262 | -4.927109947649015 | 4.927109947649015
4 | 1734296338.054751 | -3.9212515776859505 | 4.398705354995528
5 | 1734296338.112858 | -4.927109947649015 | 4.927109947649015
6 | 1734296338.1667607 | -3.9212515776859505 | 4.398705354995528
7 | 1734296338.2195761 | -3.9212515776859505 | 4.398705354995528
8 | 1734296338.2706087 | -4.927109947649015 | 4.927109947649015
9 | 1734296338.3224285 | -3.9212515776859505 | 4.398705354995528
10 | 1734296338.3750155 | -3.9212515776859505 | 4.398705354995528
11 | 1734296338.4275355 | -3.9212515776859505 | 4.398705354995528
12 | 1734296338.4843748 | -3.9212515776859505 | 4.398705354995528
13 | 1734296338.539415 | -3.9212515776859505 | 4.398705354995528
14 | 1734296338.58661 | -3.9212515776859505 | 4.398705354995528
15 | 1734296338.6458635 | -3.9212515776859505 | 4.398705354995528
16 | 1734296338.6985726 | -3.9212515776859505 | 4.398705354995528
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
