Wesleyan-Soft-Robots-Lab/ArduinoMotors/TestData/take11/sensor_data.csv

Time(s) | R1(O) | R2(O) | R3(O) | R4(O)
1734296337.867737 | 96.43 | 88.13 | 98.36 | 99.53
1734296337.9109616 | 96.38 | 88.11 | 98.34 | 99.51
1734296337.964923 | 96.35 | 88.09 | 98.29 | 99.51
1734296338.0152535 | 96.33 | 88.07 | 98.29 | 99.51
1734296338.054751 | 96.30 | 88.07 | 98.29 | 99.51
1734296338.1186361 | 96.30 | 88.07 | 98.29 | 99.51
1734296338.1667607 | 96.30 | 88.07 | 98.29 | 99.48
1734296338.2293599 | 96.30 | 88.07 | 98.26 | 99.48
1734296338.2801573 | 96.28 | 88.07 | 98.26 | 99.48
1734296338.329231 | 96.25 | 88.07 | 98.26 | 99.48
1734296338.380314 | 96.25 | 88.04 | 98.26 | 99.48
1734296338.4346297 | 96.25 | 88.04 | 98.26 | 99.45
1734296338.4843748 | 96.23 | 88.04 | 98.26 | 99.45
1734296338.552726 | 96.18 | 88.04 | 98.26 | 99.45
1734296338.599636 | 96.18 | 88.04 | 98.23 | 99.45
1734296338.6604455 | 96.18 | 88.02 | 98.23 | 99.45
1734296338.7090025 | 96.23 | 88.02 | 98.26 | 99.48
1734296338.7597911 | 96.25 | 88.02 | 98.26 | 99.48
1734296338.797452 | 96.28 | 88.04 | 98.29 | 99.48
1734296338.864809 | 96.30 | 88.04 | 98.29 | 99.48
1734296338.9236193 | 96.28 | 88.00 | 98.29 | 99.48
1734296338.981067 | 96.28 | 88.00 | 98.29 | 99.48
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
