Wesleyan-Soft-Robots-Lab/ArduinoMotors/TestData/take12/angles_output.csv

imgnum | timestamp | Angle1(deg) | Angle2(deg)
0 | 1734296412.5045874 | -1.511665790477366 | 5.325740624767718
1 | 1734296412.5424669 | -1.511665790477366 | 5.325740624767718
2 | 1734296412.5987084 | -1.511665790477366 | 5.325740624767718
3 | 1734296412.6474638 | -1.511665790477366 | 5.325740624767718
4 | 1734296412.700581 | -1.511665790477366 | 5.325740624767718
5 | 1734296412.753272 | -2.014799110156275 | 5.325740624767718
6 | 1734296412.8057992 | -2.014799110156275 | 5.325740624767718
7 | 1734296412.8682046 | -2.014799110156275 | 5.325740624767718
8 | 1734296412.912495 | -1.9872700810033734 | 5.325740624767718
9 | 1734296412.965298 | -1.9872700810033734 | 5.325740624767718
10 | 1734296413.0190206 | -1.9872700810033734 | 5.325740624767718
11 | 1734296413.0725677 | -2.014799110156275 | 5.325740624767718
12 | 1734296413.12413 | -1.9872700810033734 | 5.325740624767718
13 | 1734296413.1745286 | -2.014799110156275 | 5.325740624767718
14 | 1734296413.2284603 | -1.9872700810033734 | 5.325740624767718
15 | 1734296413.280854 | -1.9872700810033734 | 5.325740624767718
16 | 1734296413.330578 | -1.9872700810033734 | 5.325740624767718
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
