Wesleyan-Soft-Robots-Lab/ArduinoMotors/TestData/take12/sensor_data.csv

Time(s) | R1(O) | R2(O) | R3(O) | R4(O)
1734296412.5045874 | 96.43 | 88.13 | 99.11 | 99.53
1734296412.555604 | 96.40 | 88.11 | 99.08 | 99.51
1734296412.6100812 | 96.40 | 88.09 | 99.06 | 99.51
1734296412.6631806 | 96.38 | 88.07 | 99.06 | 99.51
1734296412.7162066 | 96.38 | 88.04 | 99.06 | 99.51
1734296412.753272 | 96.38 | 88.04 | 99.06 | 99.51
1734296412.8118596 | 96.38 | 88.04 | 99.06 | 99.48
1734296412.8756928 | 96.38 | 88.04 | 99.03 | 99.48
1734296412.9281163 | 96.35 | 88.02 | 99.03 | 99.48
1734296412.973843 | 96.35 | 88.00 | 99.03 | 99.48
1734296413.0375783 | 96.35 | 87.95 | 99.03 | 99.48
1734296413.0725677 | 96.35 | 87.93 | 99.03 | 99.45
1734296413.136197 | 96.33 | 87.90 | 99.03 | 99.45
1734296413.1824555 | 96.30 | 87.88 | 99.03 | 99.45
1734296413.2343826 | 96.30 | 87.88 | 99.01 | 99.45
1734296413.288612 | 96.30 | 87.86 | 99.01 | 99.45
1734296413.3494678 | 96.33 | 87.88 | 99.03 | 99.48
1734296413.408298 | 96.33 | 87.90 | 99.06 | 99.48
1734296413.4507036 | 96.35 | 87.97 | 99.08 | 99.48
1734296413.5216978 | 96.35 | 88.04 | 99.11 | 99.48
1734296413.5746288 | 96.35 | 88.07 | 99.14 | 99.51
1734296413.6171203 | 96.38 | 88.13 | 99.16 | 99.53
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
