Wesleyan-Soft-Robots-Lab/ArduinoMotors/TestData/take13/angles_output.csv

imgnum | timestamp | Angle1(deg) | Angle2(deg)
0 | 1734296536.9341276 | -5.75715661890311 | 4.325060434738461
1 | 1734296536.9702926 | -6.23421286773484 | 4.325060434738461
2 | 1734296537.028901 | -6.23421286773484 | 4.325060434738461
3 | 1734296537.0826187 | -5.75715661890311 | 4.325060434738461
4 | 1734296537.1374826 | -6.23421286773484 | 4.325060434738461
5 | 1734296537.1907694 | -6.23421286773484 | 4.325060434738461
6 | 1734296537.2442873 | -6.23421286773484 | 4.325060434738461
7 | 1734296537.3014123 | -6.23421286773484 | 4.325060434738461
8 | 1734296537.3553677 | -6.23421286773484 | 4.325060434738461
9 | 1734296537.4075067 | -6.23421286773484 | 4.325060434738461
10 | 1734296537.4612846 | -6.23421286773484 | 4.325060434738461
11 | 1734296537.5130525 | -6.23421286773484 | 4.325060434738461
12 | 1734296537.5628607 | -5.75715661890311 | 4.325060434738461
13 | 1734296537.6122677 | -6.23421286773484 | 4.325060434738461
14 | 1734296537.6649766 | -6.23421286773484 | 4.325060434738461
15 | 1734296537.7205637 | -6.23421286773484 | 4.325060434738461
16 | 1734296537.775876 | -6.23421286773484 | 4.325060434738461
17 | 1734296537.8289773 | -6.250244143061622 | 4.325060434738461
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
