Wesleyan-Soft-Robots-Lab/ArduinoMotors/TestData/take13/sensor_data.csv

Time(s) | R1(O) | R2(O) | R3(O) | R4(O)
1734296536.9341276 | 95.68 | 89.17 | 97.57 | 98.76
1734296536.982088 | 95.68 | 89.17 | 97.57 | 98.76
1734296537.034394 | 95.70 | 89.20 | 97.59 | 98.78
1734296537.0912838 | 95.73 | 89.20 | 97.62 | 98.81
1734296537.1520882 | 95.75 | 89.20 | 97.65 | 98.83
1734296537.2064407 | 95.78 | 89.20 | 97.65 | 98.83
1734296537.2599428 | 95.80 | 89.20 | 97.67 | 98.86
1734296537.3014123 | 95.80 | 89.20 | 97.70 | 98.88
1734296537.3553677 | 95.83 | 89.20 | 97.72 | 98.88
1734296537.4075067 | 95.85 | 89.20 | 97.72 | 98.91
1734296537.4673443 | 95.88 | 89.20 | 97.75 | 98.94
1734296537.5130525 | 95.90 | 89.22 | 97.77 | 98.94
1734296537.5693665 | 95.93 | 89.22 | 97.80 | 98.96
1734296537.6122677 | 95.93 | 89.22 | 97.82 | 98.99
1734296537.6676917 | 95.95 | 89.24 | 97.85 | 98.99
1734296537.728821 | 95.98 | 89.27 | 97.88 | 99.01
1734296537.775876 | 95.98 | 89.27 | 97.90 | 99.04
1734296537.8344972 | 95.98 | 89.27 | 97.90 | 99.01
1734296537.883094 | 95.98 | 89.27 | 97.90 | 99.01
1734296537.9384487 | 95.95 | 89.29 | 97.90 | 99.01
1734296538.013379 | 95.95 | 89.29 | 97.93 | 99.01
1734296538.0555615 | 95.95 | 89.29 | 97.93 | 99.01
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
