Wesleyan-Soft-Robots-Lab/ArduinoMotors/TestData/take14/angles_output.csv

imgnum | timestamp | Angle1(deg) | Angle2(deg)
0 | 1734296651.1663046 | -6.347375494048066 | 4.927109947649015
1 | 1734296651.195844 | -6.317298752281943 | 4.885202568117293
2 | 1734296651.247057 | -6.347375494048066 | 4.927109947649015
3 | 1734296651.2995539 | -6.317298752281943 | 4.885202568117293
4 | 1734296651.3485026 | -6.317298752281943 | 4.885202568117293
5 | 1734296651.410598 | -6.317298752281943 | 4.885202568117293
6 | 1734296651.4643016 | -6.317298752281943 | 4.885202568117293
7 | 1734296651.5178723 | -6.317298752281943 | 4.885202568117293
8 | 1734296651.5650325 | -6.317298752281943 | 4.885202568117293
9 | 1734296651.6184845 | -6.347375494048066 | 4.927109947649015
10 | 1734296651.6746037 | -6.347375494048066 | 4.927109947649015
11 | 1734296651.7251437 | -6.347375494048066 | 4.927109947649015
12 | 1734296651.774608 | -6.347375494048066 | 4.927109947649015
13 | 1734296651.8220217 | -6.347375494048066 | 4.927109947649015
14 | 1734296651.8804576 | -6.347375494048066 | 4.927109947649015
15 | 1734296651.931618 | -6.347375494048066 | 4.927109947649015
16 | 1734296651.9808512 | -6.347375494048066 | 4.927109947649015
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
