Wesleyan-Soft-Robots-Lab/ArduinoMotors/TestData/take14/sensor_data.csv

Time(s) | R1(O) | R2(O) | R3(O) | R4(O)
1734296651.1770818 | 95.75 | 80.23 | 97.42 | 99.12
1734296651.2042453 | 95.73 | 80.23 | 97.42 | 99.12
1734296651.26028 | 95.75 | 80.23 | 97.42 | 99.12
1734296651.3070562 | 95.78 | 80.23 | 97.42 | 99.14
1734296651.3581085 | 95.78 | 80.23 | 97.44 | 99.14
1734296651.4202855 | 95.78 | 80.23 | 97.47 | 99.14
1734296651.469021 | 95.78 | 80.23 | 97.47 | 99.14
1734296651.5258682 | 95.80 | 80.23 | 97.49 | 99.14
1734296651.5650325 | 95.83 | 80.23 | 97.49 | 99.14
1734296651.6264453 | 95.85 | 80.21 | 97.49 | 99.14
1734296651.6902258 | 95.88 | 80.21 | 97.49 | 99.14
1734296651.7251437 | 95.90 | 80.21 | 97.52 | 99.14
1734296651.7925322 | 95.93 | 80.21 | 97.52 | 99.12
1734296651.826541 | 95.95 | 80.21 | 97.52 | 99.12
1734296651.893384 | 95.98 | 80.21 | 97.54 | 99.12
1734296651.945817 | 96.00 | 80.21 | 97.54 | 99.12
1734296651.9808512 | 96.03 | 80.21 | 97.57 | 99.12
1734296652.033369 | 96.03 | 80.21 | 97.57 | 99.12
1734296652.087616 | 96.03 | 80.21 | 97.57 | 99.12
1734296652.141454 | 96.05 | 80.21 | 97.57 | 99.12
1734296652.208407 | 96.05 | 80.21 | 97.57 | 99.12
1734296652.250437 | 96.05 | 80.21 | 97.57 | 99.12
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
