Wesleyan-Soft-Robots-Lab/ArduinoMotors/TestData/take15/angles_output.csv

imgnum | timestamp | Angle1(deg) | Angle2(deg)
0 | 1734296729.4544106 | -5.874061394422483 | 4.927109947649015
1 | 1734296729.4923384 | -5.874061394422483 | 4.927109947649015
2 | 1734296729.5476763 | -5.840043821989482 | 4.885202568117293
3 | 1734296729.5974963 | -5.874061394422483 | 4.927109947649015
4 | 1734296729.6482267 | -5.881951201521204 | 4.927109947649015
5 | 1734296729.6995218 | -5.874061394422483 | 4.927109947649015
6 | 1734296729.7527127 | -5.881951201521204 | 4.927109947649015
7 | 1734296729.8052893 | -5.874061394422483 | 4.927109947649015
8 | 1734296729.8570356 | -5.881951201521204 | 4.927109947649015
9 | 1734296729.911282 | -5.881951201521204 | 4.927109947649015
10 | 1734296729.9632137 | -5.881951201521204 | 4.927109947649015
11 | 1734296730.0160122 | -5.881951201521204 | 4.927109947649015
12 | 1734296730.0692453 | -5.881951201521204 | 4.927109947649015
13 | 1734296730.1198382 | -5.400618006383951 | 4.927109947649015
14 | 1734296730.1798365 | -5.874061394422483 | 4.927109947649015
15 | 1734296730.228217 | -5.881951201521204 | 4.927109947649015
16 | 1734296730.2809713 | -5.881951201521204 | 4.927109947649015
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
