Wesleyan-Soft-Robots-Lab/ArduinoMotors/TestData/take15/sensor_data.csv

Time(s) | R1(O) | R2(O) | R3(O) | R4(O)
1734296729.4650805 | 96.43 | 83.44 | 98.34 | 99.53
1734296729.5024347 | 96.40 | 83.41 | 98.31 | 99.51
1734296729.5476763 | 96.38 | 83.39 | 98.29 | 99.51
1734296729.6131227 | 96.35 | 83.39 | 98.29 | 99.51
1734296729.6613414 | 96.33 | 83.39 | 98.29 | 99.51
1734296729.6995218 | 96.30 | 83.39 | 98.29 | 99.51
1734296729.7527127 | 96.30 | 83.39 | 98.29 | 99.48
1734296729.8208933 | 96.28 | 83.39 | 98.26 | 99.48
1734296729.8730967 | 96.25 | 83.39 | 98.26 | 99.48
1734296729.911282 | 96.25 | 83.39 | 98.26 | 99.48
1734296729.9712563 | 96.23 | 83.37 | 98.26 | 99.48
1734296730.0160122 | 96.20 | 83.37 | 98.26 | 99.45
1734296730.0760775 | 96.18 | 83.37 | 98.26 | 99.45
1734296730.1284873 | 96.15 | 83.37 | 98.26 | 99.45
1734296730.1798365 | 96.13 | 83.37 | 98.23 | 99.45
1734296730.2371686 | 96.10 | 83.37 | 98.23 | 99.45
1734296730.2809713 | 96.10 | 83.39 | 98.26 | 99.48
1734296730.336929 | 96.13 | 83.41 | 98.26 | 99.48
1734296730.394556 | 96.15 | 83.41 | 98.26 | 99.48
1734296730.4484308 | 96.18 | 83.41 | 98.26 | 99.48
1734296730.5001044 | 96.18 | 83.39 | 98.26 | 99.48
1734296730.5515153 | 96.15 | 83.41 | 98.26 | 99.48
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
