Wesleyan-Soft-Robots-Lab/ArduinoMotors/TestData/take2/angles_output.csv

imgnum | timestamp | Angle1(deg) | Angle2(deg)
0 | 1734295333.9397192 | 18.03582604177126 | 2.405970516645297
1 | 1734295333.9641535 | 18.03582604177126 | 2.405970516645297
2 | 1734295334.013392 | 18.03582604177126 | 2.405970516645297
3 | 1734295334.0633757 | 18.03582604177126 | 2.405970516645297
4 | 1734295334.1158335 | 18.03582604177126 | 2.405970516645297
5 | 1734295334.17166 | 18.03582604177126 | 2.405970516645297
6 | 1734295334.223026 | 18.03582604177126 | 2.405970516645297
7 | 1734295334.278497 | 18.03582604177126 | 2.405970516645297
8 | 1734295334.3299189 | 18.03582604177126 | 2.405970516645297
9 | 1734295334.3944016 | 18.03582604177126 | 2.405970516645297
10 | 1734295334.4481452 | 18.03582604177126 | 2.405970516645297
11 | 1734295334.503282 | 18.03582604177126 | 2.405970516645297
12 | 1734295334.5549445 | 18.03582604177126 | 2.405970516645297
13 | 1734295334.6070986 | 18.03582604177126 | 2.405970516645297
14 | 1734295334.6637554 | 18.03582604177126 | 2.405970516645297
15 | 1734295334.7142918 | 18.03582604177126 | 2.405970516645297
16 | 1734295334.7664385 | 18.03582604177126 | 2.405970516645297
17 | 1734295334.8363223 | 18.03582604177126 | 2.405970516645297
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
