Wesleyan-Soft-Robots-Lab/ArduinoMotors/TestData/take2/sensor_data.csv

Time(s) | R1(O) | R2(O) | R3(O) | R4(O)
1734295333.9397192 | Percentage: | 87 | Potval2:otval2: | 28
1734295333.9641535 | 96.35 | 93.09 | 99.11 | 99.48
1734295334.022006 | 96.35 | 93.09 | 99.11 | 99.48
1734295334.0693748 | 96.35 | 93.09 | 99.11 | 99.48
1734295334.1158335 | 96.40 | 93.07 | 99.11 | 99.51
1734295334.1909587 | 96.40 | 93.07 | 99.11 | 99.51
1734295334.2387912 | 96.40 | 93.04 | 99.11 | 99.51
1734295334.278497 | 96.38 | 93.04 | 99.11 | 99.51
1734295334.3362675 | 96.38 | 93.04 | 99.11 | 99.48
1734295334.4100277 | 96.38 | 93.02 | 99.11 | 99.48
1734295334.4481452 | 96.35 | 93.02 | 99.11 | 99.48
1734295334.516584 | 96.35 | 93.02 | 99.11 | 99.45
1734295334.5705714 | 96.35 | 93.02 | 99.11 | 99.45
1734295334.615666 | 96.35 | 93.02 | 99.11 | 99.45
1734295334.6753771 | 96.35 | 93.02 | 99.11 | 99.43
1734295334.7259135 | 96.33 | 93.02 | 99.11 | 99.43
1734295334.776509 | 96.30 | 93.02 | 99.11 | 99.43
1734295334.8417306 | 96.30 | 93.02 | 99.11 | 99.40
1734295334.893167 | 96.30 | 93.02 | 99.11 | 99.40
1734295334.95176 | 96.30 | 93.02 | 99.11 | 99.43
1734295335.002908 | 96.30 | 93.02 | 99.11 | 99.40
1734295335.056524 | 96.28 | 93.04 | 99.11 | 99.40
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
