Wesleyan-Soft-Robots-Lab/ArduinoMotors/TestData/take3/angles_output.csv

imgnum | timestamp | Angle1(deg) | Angle2(deg)
0 | 1734295485.029005 | 10.850435244043766 | 27.439727948199305
1 | 1734295485.0514164 | 11.369286635352815 | 27.21611155730747
2 | 1734295485.1023269 | 11.369286635352815 | 27.21611155730747
3 | 1734295485.1532655 | 11.369286635352815 | 27.21611155730747
4 | 1734295485.20499 | 11.369286635352815 | 27.21611155730747
5 | 1734295485.2638016 | 11.369286635352815 | 27.21611155730747
6 | 1734295485.3135855 | 11.369286635352815 | 27.21611155730747
7 | 1734295485.3796391 | 11.369286635352815 | 27.21611155730747
8 | 1734295485.4332376 | 11.369286635352815 | 27.21611155730747
9 | 1734295485.4860923 | 11.369286635352815 | 27.21611155730747
10 | 1734295485.545487 | 11.369286635352815 | 27.21611155730747
11 | 1734295485.601065 | 11.369286635352815 | 27.21611155730747
12 | 1734295485.6548991 | 11.369286635352815 | 27.21611155730747
13 | 1734295485.7072873 | 11.369286635352815 | 27.21611155730747
14 | 1734295485.757956 | 11.369286635352815 | 27.21611155730747
15 | 1734295485.809245 | 11.369286635352815 | 27.21611155730747
16 | 1734295485.8591821 | 11.369286635352815 | 27.21611155730747
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
