Wesleyan-Soft-Robots-Lab/ArduinoMotors/TestData/take3/sensor_data.csv

Time(s) | R1(O) | R2(O) | R3(O) | R4(O)
1734295485.029005 | 99.89 | 89.87 | 97.95 | 101.90
1734295485.0581975 | 99.89 | 89.87 | 97.95 | 101.88
1734295485.11189 | 99.89 | 89.87 | 97.95 | 101.88
1734295485.1632984 | 99.89 | 89.87 | 97.95 | 101.88
1734295485.2120335 | 99.89 | 89.87 | 97.95 | 101.88
1734295485.2758348 | 99.89 | 89.87 | 97.95 | 101.88
1734295485.3200924 | 99.89 | 89.87 | 97.95 | 101.88
1734295485.3952622 | 99.89 | 89.87 | 97.95 | 101.85
1734295485.4332376 | 99.89 | 89.87 | 97.95 | 101.85
1734295485.4925096 | 99.89 | 89.87 | 97.95 | 101.85
1734295485.545487 | 99.89 | 89.87 | 97.95 | 101.85
1734295485.601065 | 99.89 | 89.87 | 97.95 | 101.85
1734295485.6729746 | 99.89 | 89.87 | 97.95 | 101.85
1734295485.7153585 | 99.89 | 89.87 | 97.95 | 101.85
1734295485.7599556 | 99.89 | 89.87 | 97.95 | 101.85
1734295485.8162775 | 99.89 | 89.87 | 97.95 | 101.82
1734295485.8651872 | 99.89 | 89.87 | 97.95 | 101.82
1734295485.9129915 | 99.89 | 89.87 | 97.95 | 101.82
1734295485.9684064 | 99.89 | 89.87 | 97.95 | 101.82
1734295486.037702 | 99.89 | 89.87 | 97.95 | 101.82
1734295486.084713 | 99.89 | 89.87 | 97.95 | 101.82
1734295486.141506 | 99.89 | 89.87 | 97.95 | 101.82
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
