Wesleyan-Soft-Robots-Lab/ArduinoMotors/TestData/take4/angles_output.csv

imgnum | timestamp | Angle1(deg) | Angle2(deg)
0 | 1734295555.7164683 | 9.203140353559661 | 27.66675729228436
1 | 1734295555.754957 | 9.203140353559661 | 27.66675729228436
2 | 1734295555.8067055 | 9.203140353559661 | 27.66675729228436
3 | 1734295555.8570135 | 9.203140353559661 | 27.66675729228436
4 | 1734295555.9122324 | 9.203140353559661 | 27.66675729228436
5 | 1734295555.9675596 | 9.203140353559661 | 27.66675729228436
6 | 1734295556.0207472 | 9.203140353559661 | 27.66675729228436
7 | 1734295556.0740242 | 9.203140353559661 | 27.66675729228436
8 | 1734295556.1271973 | 9.203140353559661 | 27.66675729228436
9 | 1734295556.1812134 | 9.203140353559661 | 27.66675729228436
10 | 1734295556.2326436 | 9.203140353559661 | 27.66675729228436
11 | 1734295556.2870061 | 9.203140353559661 | 27.66675729228436
12 | 1734295556.3377402 | 9.203140353559661 | 27.66675729228436
13 | 1734295556.3901575 | 9.203140353559661 | 27.66675729228436
14 | 1734295556.4486902 | 9.203140353559661 | 27.66675729228436
15 | 1734295556.4975853 | 9.203140353559661 | 27.66675729228436
16 | 1734295556.5495749 | 9.203140353559661 | 27.66675729228436
17 | 1734295556.6032562 | 9.203140353559661 | 27.66675729228436
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
