Wesleyan-Soft-Robots-Lab/ArduinoMotors/TestData/take4/sensor_data.csv

Time(s) | R1(O) | R2(O) | R3(O) | R4(O)
1734295555.7323613 | 99.92 | 89.87 | 97.98 | 101.90
1734295555.7643123 | 99.92 | 89.87 | 97.98 | 101.88
1734295555.8197765 | 99.92 | 89.87 | 97.98 | 101.88
1734295555.8650188 | 99.92 | 89.87 | 97.98 | 101.88
1734295555.919389 | 99.92 | 89.87 | 97.98 | 101.88
1734295555.9831824 | 99.92 | 89.87 | 97.98 | 101.88
1734295556.0267806 | 99.92 | 89.87 | 98.00 | 101.88
1734295556.091828 | 99.92 | 89.87 | 98.00 | 101.88
1734295556.1271973 | 99.92 | 89.87 | 98.00 | 101.88
1734295556.1865995 | 99.92 | 89.87 | 98.00 | 101.88
1734295556.2397614 | 99.89 | 89.87 | 97.98 | 101.88
1734295556.2870061 | 99.89 | 89.87 | 97.98 | 101.88
1734295556.3443108 | 99.89 | 89.87 | 97.98 | 101.88
1734295556.4129162 | 99.89 | 89.87 | 97.98 | 101.88
1734295556.46183 | 99.89 | 89.87 | 97.98 | 101.88
1734295556.5057514 | 99.89 | 89.87 | 97.98 | 101.88
1734295556.5720527 | 99.89 | 89.87 | 97.98 | 101.88
1734295556.6090233 | 99.89 | 89.87 | 97.98 | 101.88
1734295556.6592908 | 99.89 | 89.87 | 97.98 | 101.88
1734295556.7322264 | 99.89 | 89.87 | 97.98 | 101.88
1734295556.7695522 | 99.89 | 89.87 | 97.98 | 101.88
1734295556.8316438 | 99.89 | 89.87 | 97.95 | 101.88
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
