Wesleyan-Soft-Robots-Lab/ArduinoMotors/TestData/take5/angles_output.csv

imgnum | timestamp | Angle1(deg) | Angle2(deg)
0 | 1734295710.6689413 | 38.38234259207582 | 27.456742284599876
1 | 1734295710.7080538 | 38.38234259207582 | 27.456742284599876
2 | 1734295710.7639594 | 38.38234259207582 | 27.456742284599876
3 | 1734295710.8151667 | 38.38234259207582 | 27.456742284599876
4 | 1734295710.8704915 | 38.38234259207582 | 27.456742284599876
5 | 1734295710.9234486 | 38.38234259207582 | 27.456742284599876
6 | 1734295710.9785297 | 38.18080470008794 | 27.456742284599876
7 | 1734295711.031619 | 38.18080470008794 | 27.456742284599876
8 | 1734295711.0842996 | 38.18080470008794 | 27.456742284599876
9 | 1734295711.1307633 | 37.73384933994058 | 27.456742284599876
10 | 1734295711.1842616 | 38.18080470008794 | 27.456742284599876
11 | 1734295711.2377589 | 38.18080470008794 | 27.456742284599876
12 | 1734295711.2927322 | 37.73384933994058 | 27.456742284599876
13 | 1734295711.343647 | 37.73384933994058 | 27.456742284599876
14 | 1734295711.3938525 | 37.73384933994058 | 27.456742284599876
15 | 1734295711.4450507 | 37.73384933994058 | 27.456742284599876
16 | 1734295711.4970517 | 37.938133797448494 | 27.456742284599876
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
