Wesleyan-Soft-Robots-Lab/ArduinoMotors/TestData/take5/sensor_data.csv

Time(s) | R1(O) | R2(O) | R3(O) | R4(O)
1734295710.6845672 | 871 | mapval1 | 217 | Percentage:
1734295710.7275407 | 100.26 | 94.49 | 99.50 | 101.888
1734295710.7785017 | 100.26 | 94.49 | 99.50 | 101.8Resistance:
1734295710.8278456 | 99.86 | 93.97 | 99.16 | 101.50
1734295710.8737211 | 99.89 | 94.00 | 99.14 | 101.53
1734295710.9311566 | 99.94 | 94.02 | 99.14 | 101.56
1734295710.9847734 | 99.97 | 94.02 | 99.16 | 101.58
1734295711.031619 | 99.97 | 94.02 | 99.19 | 101.61
1734295711.0929134 | 99.99 | 94.07 | 99.21 | 101.61
1734295711.135869 | 100.02 | 94.12 | 99.27 | 101.64
1734295711.1842616 | 100.05 | 94.14 | 99.29 | 101.66
1734295711.244846 | 100.07 | 94.17 | 99.29 | 101.69
1734295711.313685 | 100.10 | 94.22 | 99.32 | 101.72
1734295711.3577683 | 100.13 | 94.27 | 99.34 | 101.74
1734295711.4068496 | 100.13 | 94.32 | 99.37 | 101.77
1734295711.448146 | 100.15 | 94.36 | 99.40 | 101.77
1734295711.4970517 | 100.18 | 94.39 | 99.42 | 101.80
1734295711.5474844 | 100.20 | 94.44 | 99.45 | 101.82
1734295711.6096191 | 100.23 | 94.44 | 99.47 | 101.85
1734295711.6666548 | 100.23 | 94.46 | 99.50 | 101.82
1734295711.7179508 | 100.23 | 94.46 | 99.50 | 101.82
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
