Wesleyan-Soft-Robots-Lab/ArduinoMotors/TestData/take6/angles_output.csv

imgnum | timestamp | Angle1(deg) | Angle2(deg)
0 | 1734295803.4628415 | 39.04589256883497 | 28.334242483124598
1 | 1734295803.5059497 | 38.595345267050746 | 28.334242483124598
2 | 1734295803.5650363 | 39.04589256883497 | 28.334242483124598
3 | 1734295803.6154644 | 39.04589256883497 | 28.334242483124598
4 | 1734295803.666274 | 38.595345267050746 | 28.334242483124598
5 | 1734295803.72004 | 39.04589256883497 | 28.334242483124598
6 | 1734295803.7750182 | 38.595345267050746 | 28.334242483124598
7 | 1734295803.8284183 | 39.04589256883497 | 28.334242483124598
8 | 1734295803.8797262 | 39.04589256883497 | 28.334242483124598
9 | 1734295803.9328544 | 38.595345267050746 | 28.334242483124598
10 | 1734295803.9877632 | 38.595345267050746 | 28.334242483124598
11 | 1734295804.047348 | 38.595345267050746 | 28.334242483124598
12 | 1734295804.0999584 | 39.04589256883497 | 28.334242483124598
13 | 1734295804.1486444 | 38.595345267050746 | 28.334242483124598
14 | 1734295804.1983037 | 38.595345267050746 | 28.334242483124598
15 | 1734295804.2628295 | 38.40257201423242 | 28.334242483124598
16 | 1734295804.315258 | 38.40257201423242 | 28.334242483124598
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
