Wesleyan-Soft-Robots-Lab/ArduinoMotors/TestData/take6/sensor_data.csv

Time(s) | R1(O) | R2(O) | R3(O) | R4(O)
1734295803.4773111 | 85 | Potval2: | 86869 | mapval2:
1734295803.5153291 | 100.15 | 94.49 | 99.42 | 101.85
1734295803.5783865 | 100.26 | 94.54 | 99.47 | 101.88
1734295803.6284626 | 100.26 | 94.51 | 99.47 | 101.88
1734295803.666274 | 100.23 | 94.51 | 99.47 | 101.88
1734295803.72004 | 100.20 | 94.51 | 99.47 | 101.88
1734295803.7980387 | 100.20 | 94.51 | 99.47 | 101.88
1734295803.841412 | 100.20 | 94.51 | 99.45 | 101.88
1734295803.8797262 | 100.18 | 94.49 | 99.45 | 101.88
1734295803.9363973 | 100.18 | 94.46 | 99.45 | 101.88
1734295803.9959095 | 100.18 | 94.46 | 99.45 | 101.88
1734295804.0610318 | 100.15 | 94.46 | 99.45 | 101.88
1734295804.112823 | 100.15 | 94.44 | 99.45 | 101.88
1734295804.1550937 | 100.15 | 94.44 | 99.45 | 101.85
1734295804.1983037 | 100.13 | 94.44 | 99.45 | 101.85
1734295804.2628295 | 100.10 | 94.44 | 99.45 | 101.85
1734295804.315258 | 100.10 | 94.44 | 99.42 | 101.85
1734295804.3727212 | 100.13 | 94.46 | 99.45 | 101.88
1734295804.4192605 | 100.10 | 94.49 | 99.45 | 101.88
1734295804.4729092 | 100.13 | 94.46 | 99.45 | 101.88
1734295804.528455 | 100.15 | 94.46 | 99.45 | 101.85
1734295804.5949936 | 100.15 | 94.46 | 99.45 | 101.85
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
