Wesleyan-Soft-Robots-Lab/ArduinoMotors/TestData/take7/angles_output.csv

imgnum | timestamp | Angle1(deg) | Angle2(deg)
0 | 1734295952.3358665 | -3.368576312737801 | 3.8460300900473783
1 | 1734295952.3760753 | -3.368576312737801 | 3.8460300900473783
2 | 1734295952.4247944 | -3.368576312737801 | 3.8460300900473783
3 | 1734295952.4743679 | -3.368576312737801 | 3.8460300900473783
4 | 1734295952.5305128 | -3.368576312737801 | 3.8460300900473783
5 | 1734295952.5851119 | -3.368576312737801 | 3.8460300900473783
6 | 1734295952.646531 | -3.368576312737801 | 3.8460300900473783
7 | 1734295952.7009099 | -3.368576312737801 | 3.8460300900473783
8 | 1734295952.7546077 | -3.368576312737801 | 3.8460300900473783
9 | 1734295952.807229 | -3.368576312737801 | 3.8460300900473783
10 | 1734295952.8590176 | -3.368576312737801 | 3.8460300900473783
11 | 1734295952.9122937 | -3.368576312737801 | 3.8460300900473783
12 | 1734295952.964047 | -3.368576312737801 | 3.8460300900473783
13 | 1734295953.0148404 | -3.368576312737801 | 3.8460300900473783
14 | 1734295953.063665 | -3.368576312737801 | 3.8460300900473783
15 | 1734295953.1162133 | -3.368576312737801 | 3.8460300900473783
16 | 1734295953.1783772 | -3.368576312737801 | 3.8460300900473783
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
