Wesleyan-Soft-Robots-Lab/ArduinoMotors/TestData/take7/sensor_data.csv

Time(s) | R1(O) | R2(O) | R3(O) | R4(O)
1734295952.3515184 | 0 | mapval2: | 0 | Percentage:
1734295952.394799 | 147619 | 96.03 | 91.65 | 97.85
1734295952.4440196 | 10 | 95.68 | 90.58 | 97.57
1734295952.4743679 | 95.68 | 90.58 | 97.57 | 98.76
1734295952.5305128 | 95.70 | 90.60 | 97.57 | 98.78
1734295952.5928552 | 95.73 | 90.63 | 97.57 | 98.81
1734295952.652483 | 95.75 | 90.65 | 97.57 | 98.83
1734295952.7169344 | 95.78 | 90.67 | 97.57 | 98.83
1734295952.7703793 | 95.80 | 90.67 | 97.57 | 98.86
1734295952.8127563 | 95.80 | 90.70 | 97.57 | 98.88
1734295952.864518 | 95.83 | 90.75 | 97.59 | 98.88
1734295952.9142814 | 95.85 | 90.82 | 97.59 | 98.91
1734295952.9838338 | 95.88 | 90.93 | 97.65 | 98.94
1734295953.0148404 | 95.90 | 91.08 | 97.70 | 98.94
1734295953.063665 | 95.90 | 91.22 | 97.75 | 98.96
1734295953.1222098 | 95.90 | 91.39 | 97.80 | 98.99
1734295953.1783772 | 95.93 | 91.55 | 97.85 | 98.99
1734295953.2342458 | 95.93 | 91.72 | 97.90 | 99.01
1734295953.2854488 | 95.93 | 91.89 | 97.95 | 99.04
1734295953.3393555 | 95.93 | 92.01 | 98.00 | 99.01
1734295953.3936427 | 95.93 | 92.13 | 98.05 | 99.01
1734295953.4578474 | 95.90 | 92.22 | 98.11 | 99.01
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
