Wesleyan-Soft-Robots-Lab/ArduinoMotors/TestData/take8/angles_output.csv

imgnum | timestamp | Angle1(deg) | Angle2(deg)
0 | 1734296022.1087637 | -1.0379272145418668 | 3.4238712449306803
1 | 1734296022.1473868 | -1.0379272145418668 | 3.4238712449306803
2 | 1734296022.1980605 | -1.0379272145418668 | 3.4238712449306803
3 | 1734296022.2497146 | -1.0379272145418668 | 3.4238712449306803
4 | 1734296022.2992792 | -1.0379272145418668 | 3.4238712449306803
5 | 1734296022.3551352 | -1.0379272145418668 | 3.4238712449306803
6 | 1734296022.405758 | -1.5147188119343014 | 3.4238712449306803
7 | 1734296022.456886 | -1.0379272145418668 | 3.4238712449306803
8 | 1734296022.512708 | -1.0379272145418668 | 3.4238712449306803
9 | 1734296022.5644426 | -1.0379272145418668 | 3.4238712449306803
10 | 1734296022.618967 | -1.0379272145418668 | 3.4238712449306803
11 | 1734296022.6683083 | -1.0379272145418668 | 3.4238712449306803
12 | 1734296022.7194762 | -1.0379272145418668 | 3.4238712449306803
13 | 1734296022.7699647 | -1.0379272145418668 | 3.4238712449306803
14 | 1734296022.8294358 | -1.0379272145418668 | 3.4238712449306803
15 | 1734296022.882821 | -1.0179007282853831 | 3.4238712449306803
16 | 1734296022.9353669 | -1.0179007282853831 | 3.4238712449306803
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
