Wesleyan-Soft-Robots-Lab/ArduinoMotors/TestData/take8/sensor_data.csv

Time(s) | R1(O) | R2(O) | R3(O) | R4(O)
1734296022.122773 | Potval2: | 0 | mapval2: | 0
1734296022.1562123 | 95.95 | 90.58 | 97.88 | 99.01
1734296022.2064655 | 96.03 | 90.63 | 97.93 | 99.12
1734296022.265339 | 96.03 | 90.63 | 97.90 | 99.12
1734296022.2992792 | 96.03 | 90.63 | 97.90 | 99.12
1734296022.358605 | 96.00 | 90.63 | 97.90 | 99.12
1734296022.4116647 | 96.00 | 90.63 | 97.88 | 99.09
1734296022.4625704 | 96.00 | 90.63 | 97.88 | 99.09
1734296022.512708 | 95.98 | 90.63 | 97.88 | 99.09
1734296022.5644426 | 95.98 | 90.63 | 97.88 | 99.07
1734296022.6262827 | 95.98 | 90.63 | 97.85 | 99.07
1734296022.6683083 | 95.98 | 90.63 | 97.85 | 99.07
1734296022.7297034 | 95.98 | 90.63 | 97.85 | 99.04
1734296022.774963 | 95.98 | 90.63 | 97.85 | 99.04
1734296022.8294358 | 95.95 | 90.63 | 97.85 | 99.04
1734296022.8842676 | 95.93 | 90.65 | 97.85 | 99.01
1734296022.9477346 | 95.90 | 90.75 | 97.88 | 99.01
1734296023.0002177 | 95.90 | 90.86 | 97.93 | 99.04
1734296023.0511158 | 95.88 | 91.01 | 98.00 | 99.01
1734296023.1033266 | 95.85 | 91.17 | 98.05 | 98.99
1734296023.1579678 | 95.85 | 91.34 | 98.11 | 98.99
1734296023.2241633 | 95.83 | 91.51 | 98.18 | 98.99
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
