Wesleyan-Soft-Robots-Lab/ArduinoMotors/TestData/take9/angles_output.csv

imgnum | timestamp | Angle1(deg) | Angle2(deg)
0 | 1734296140.4727352 | -6.236081882317308 | 5.2812406284451185
1 | 1734296140.5142221 | -6.236081882317308 | 5.2812406284451185
2 | 1734296140.5623019 | -5.276993817804012 | 4.803485759069076
3 | 1734296140.6145742 | -6.228192075218587 | 5.2812406284451185
4 | 1734296140.6648102 | -6.236081882317308 | 5.2812406284451185
5 | 1734296140.7147753 | -6.236081882317308 | 5.2812406284451185
6 | 1734296140.7681775 | -5.276993817804012 | 4.803485759069076
7 | 1734296140.8211188 | -5.276993817804012 | 4.803485759069076
8 | 1734296140.8726242 | -5.276993817804012 | 4.803485759069076
9 | 1734296140.9263499 | -5.276993817804012 | 4.803485759069076
10 | 1734296140.9817362 | -5.276993817804012 | 4.803485759069076
11 | 1734296141.030013 | -5.750437205842545 | 4.803485759069076
12 | 1734296141.0826154 | -5.750437205842545 | 4.803485759069076
13 | 1734296141.1315308 | -5.718482944598364 | 4.763641690726175
14 | 1734296141.1838963 | -5.718482944598364 | 4.763641690726175
15 | 1734296141.2449872 | -6.223751305468127 | 4.803485759069076
16 | 1734296141.2944808 | -6.207767221662024 | 4.763641690726175
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
