Wesleyan-Soft-Robots-Lab/ArduinoMotors/TestData/take9/sensor_data.csv

Time(s) | R1(O) | R2(O) | R3(O) | R4(O)
1734296140.4872375 | 96.05 | 90.65 | 98.34 | 99.30
1734296140.5247731 | 96.05 | 90.65 | 98.34 | 99.27
1734296140.564072 | 96.05 | 90.65 | 98.34 | 99.27
1734296140.6145742 | 96.05 | 90.63 | 98.34 | 99.27
1734296140.6648102 | 96.05 | 90.63 | 98.34 | 99.25
1734296140.7147753 | 96.05 | 90.63 | 98.34 | 99.25
1734296140.7792337 | 96.05 | 90.63 | 98.34 | 99.22
1734296140.8211188 | 96.05 | 90.63 | 98.34 | 99.22
1734296140.8784747 | 96.05 | 90.63 | 98.34 | 99.22
1734296140.9263499 | 96.05 | 90.63 | 98.34 | 99.20
1734296140.9897332 | 96.05 | 90.63 | 98.34 | 99.20
1734296141.0411842 | 96.05 | 90.63 | 98.34 | 99.17
1734296141.0908747 | 96.08 | 90.63 | 98.34 | 99.17
1734296141.1315308 | 96.10 | 90.60 | 98.34 | 99.20
1734296141.1913524 | 96.15 | 90.60 | 98.34 | 99.25
1734296141.2546525 | 96.23 | 90.58 | 98.34 | 99.30
1734296141.2944808 | 96.33 | 90.58 | 98.34 | 99.38
1734296141.3499646 | 96.43 | 90.58 | 98.34 | 99.45
1734296141.3989046 | 96.53 | 90.58 | 98.34 | 99.53
1734296141.452313 | 96.61 | 90.58 | 98.34 | 99.58
1734296141.5110984 | 96.66 | 90.58 | 98.34 | 99.64
1734296141.5737212 | 96.71 | 90.58 | 98.34 | 99.69
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
