Wesleyan-Soft-Robots-Lab/ArduinoMotors/TestData/matched_data/res_angle_data_1.csv

Time(s) | R1(O) | R2(O) | R3(O) | R4(O) | Angle1(deg) | Angle2(deg)
1734294927.872889 | 96.4 | 92.32 | 99.11 | 99.53 | 16.011828371399204 | 2.8864185438646075
1734294927.9257357 | 96.4 | 92.32 | 99.11 | 99.53 | 16.011828371399204 | 2.8864185438646075
1734294927.9788358 | 96.4 | 92.32 | 99.11 | 99.51 | 16.011828371399204 | 2.8864185438646075
1734294928.0346138 | 96.4 | 92.3 | 99.11 | 99.51 | 16.011828371399204 | 2.8864185438646075
1734294928.0942788 | 96.38 | 92.3 | 99.11 | 99.51 | 16.011828371399204 | 2.8864185438646075
1734294928.158494 | 96.38 | 92.3 | 99.11 | 99.51 | 16.011828371399204 | 2.8864185438646075
1734294928.2024095 | 96.38 | 92.3 | 99.11 | 99.51 | 16.011828371399204 | 2.8864185438646075
1734294928.2462387 | 96.38 | 92.3 | 99.11 | 99.51 | 16.011828371399204 | 2.8864185438646075
1734294928.294531 | 96.38 | 92.3 | 99.11 | 99.51 | 16.011828371399204 | 2.8864185438646075
1734294928.3491688 | 96.38 | 92.3 | 99.11 | 99.51 | 15.548530279057402 | 2.8864185438646075
1734294928.4074695 | 96.35 | 92.3 | 99.11 | 99.51 | 16.011828371399204 | 2.8864185438646075
1734294928.44922 | 96.35 | 92.3 | 99.11 | 99.48 | 16.011828371399204 | 2.8864185438646075
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
