Wesleyan-Soft-Robots-Lab/ArduinoMotors/Checkports.py

import serial.tools.list_ports

def get_ports():
    ports = serial.tools.list_ports.comports()

    return ports

def findArduino(portsFound):
    commPort = 'None'
    numConnection = len(portsFound)

    for i in range(0, numConnection):
        port = portsFound[i]
        strPort = str(port)

        if 'Arduino' in strPort:
            splitPort = strPort.split(' ')
            commPort = (splitPort[0])
    return commPort

foundPorts = get_ports()
connectPort = findArduino(foundPorts)

if connectPort != 'None':
    ser = serial.Serial(connectPort, baudrate=9600, timeout=1)
    print('Connected to ' + connectPort)
else:
    print('Connection issue!')

print('Done')
