Wesleyan-Soft-Robots-Lab/ArduinoMotors/(commit log)

2023-10-15 Basic beginner solenoid code
2024-02-16 Add files via upload
    STL file for 3D printed solenoid 6V tray (holds 2)
    [Solenoid6V_Tray_2_15.stl]
2024-04-30 Finished instructions for using the pneumatic board and airpump
2024-04-30 organization edits
    [Solenoid6V_Tray_2_15.stl, imsad.stl, solenoid.3mf, solenoid.blend, solenoid.stl, solenoidvalve2.3mf, solenoidvalve2.stl, solval3.3mf]
2024-05-17 Update airpumpcontrol.ino Individual control
    Added individual control to pairs of air valves.
2024-10-04 Update Pneumaticbuild.md
    Updated description of diode.
2024-10-04 Update Pneumaticbuild.md
    Updated the description of the transistors used.
2024-11-04 resistance readings
2024-11-05 updated pnumatic documentation + added step about regulator + image + update log
2024-11-08 learned how to make csv files
    [sensor_data.csv]
2024-11-09 Update Pneumaticbuild.md
    Add resistance range to potentiometer
2024-11-12 documentation for making sensor tubes
2024-11-15 adding some data
    [sensor_data_5.csv, sensor_data_6.csv]
2024-11-21 adding data
    [sensor_data_7.csv, sensor_data_8.csv]
2024-11-23 functional angle detector simon
    [angle_data_0.csv, angle_data_1.csv]
2024-11-24 messing around
    [angle_data_10.csv, angle_data_11.csv, angle_data_12.csv, angle_data_6.csv, angle_data_7.csv, angle_data_8.csv, angle_data_9.csv]
2024-11-30 res and angle combined
    [angle_data_13.csv]
2024-12-02 added script to record image data in frame and record sensor data using serial monitor
2024-12-02 sorta worked
    [sensor_data_14.csv, sensor_data_15.csv, sensor_data_16.csv, sensor_data_17.csv, sensor_data_18.csv]
2024-12-03 made it work cuz im cool
    [angle_data_14.csv]
2024-12-05 work work work work work
    [angle_data_14.csv, angle_data_16.csv]
2024-12-06 need this
    [angle_data_17.csv]
2024-12-07 something works B)
    [angles_output.csv]
2024-12-08 frustrated af
    [sensor_data_1.csv]
2024-12-09 csv angle data isn't null and csv is sorted
    [angles_output.csv]
2024-12-11 made this work because im really cool
    [angles_output.csv]
2024-12-11 training successful
    [angle_data_25.csv, angle_data_26.csv, angle_data_27.csv, angle_data_28.csv, angle_data_3.csv, angle_data_4.csv, angle_data_5.csv, sensor_data_21.csv]
2024-12-14 CV2 NOOO
    [angle_data_0.csv, angle_data_1.csv, angle_data_2.csv, angle_data_8.csv, angles_output.csv, sensor_data_0.csv, sensor_data_1.csv, sensor_data_2.csv]
2024-12-15 data gathered
    [angle_data_0.csv, angle_data_8.csv, angles_output.csv, sensor_data.csv]
2024-12-15 not functioning
    [res_angle_data_1.csv, res_angle_data_2.csv, res_angle_data_3.csv, res_angle_data_4.csv, res_angle_data_5.csv, res_angle_data_6.csv]
2024-12-15 Chris & Sonia trying to train the model
    [angles_output.csv, res_angle_data_1 copy.csv, res_angle_data_1.csv, res_angle_data_10.csv, res_angle_data_11.csv, res_angle_data_12.csv, res_angle_data_13.csv, res_angle_data_14.csv]
2024-12-16 the problem was i was unsqueezing 1 instead of 0
    [test_for_serial_sending.py]
2024-12-17 wrote the script out to receive and send readings to arduino
    [predictions.csv, predictions1.csv]
2024-12-19 written the basic logic for sending to the arduino. just need to work out how to process inputs just like our model
2024-12-23 uncomment predictions, comment print
2024-12-23 we should only have solenoid commands 1 and 2
2024-12-23 solenoid command starts in the middle (255)
2024-12-23 fixed serial command numbering in setup()
    [position_control_with_sensors.ino]
2025-01-12 got a successful run in using the machine learning to control the arm under videos
    [angle_data_29.csv, angle_data_30.csv, angle_data_31.csv, angle_data_32.csv, angle_data_33.csv]
